kgregg384/SUNLU_AMS_Heater_AutoVent/README.md

# SUNLU AMS Heater Auto-Vent Controller

An intelligent, automatic vent controller for SUNLU AMS 3D printer filament dryers. It monitors AC current draw to detect heater and fan states, then drives a servo-operated vent to manage moisture removal, temperature, and energy consumption — all without any manual intervention.

## How It Works

The controller uses a hall-effect current sensor (ACS758) to non-invasively monitor your dryer's power consumption. A 16-bit ADC (ADS1115) provides precise current measurements, allowing the system to distinguish between three states:

- **Heater + Fan running** — vent opens immediately
- **Fan only** (after the heater stops) — vent stays open for a 3-minute cooldown, then closes
- **Idle** — vent closes immediately

A self-learning calibration mode lets the controller adapt to your specific dryer model by measuring the actual current signatures.

## Features

- **Automatic operation** — no manual vent management needed
- **Self-learning calibration** — adapts to any compatible dryer
- **Non-volatile storage** — learned thresholds survive power cycles
- **Servo position feedback** — closed-loop vent positioning
- **Dual board support** — works with Seeed XIAO SAMD21 or RP2040
- **Single-button interface** — short/long/very-long press for different functions
- **LED status indication** — see what the controller is doing at a glance
- **Serial debug console** — full diagnostic output and manual control commands
- **Serial Monitor app** — GUI tool with color-coded output, quick command buttons, and remote learning mode
- **Pre-built UF2 firmware** — flash without compiling using drag-and-drop

## Hardware

### Components

| Component | Model | Purpose |
|---|---|---|
| Microcontroller | Seeed XIAO SAMD21 **or** RP2040 | Main controller (identical pinout) |
| Current Sensor | ACS758 LCB-050B | AC current measurement (±50A) |
| ADC | ADS1115 | 16-bit I2C analog-to-digital converter |
| Servo | Feedback-enabled servo | Vent actuation with position feedback |
| Button + LED | Mini illuminated pushbutton (Adafruit 3104 or 3105) | Button and status LED in one part; series resistors are on the PCB |
| PCB | Custom (from [3dcreator.shop](https://3dcreator.shop)) | Bare board or kit with components |

You'll also need a 5V power source rated over 1A (barrel jack, or a quality 2A USB-C adapter into the XIAO). The full parts list is in the [Build Guide](BUILD_GUIDE.md).

### Pin Configuration

| Pin | Function | Notes |
|-----|---|---|
| D0 | Servo PWM | Output |
| D3 | Button | Input, active low, internal pullup |
| D10 | Status LED | Active low |
| SDA/SCL | I2C | ADS1115 @ address 0x48 |

ADS1115 channels: A0 = current sensor, A1 = servo feedback.

### 3D Printed Parts

STL files for the vent mechanism and mounting hardware are available at MakerWorld. Approximate print time: ~4 hours.
  - V1: https://makerworld.com/en/models/2038244-sunlu-ams-heater-autovent#profileId-2198796
  - V2: https://makerworld.com/en/models/2344707-autovent-2-0-for-sunlu-ams-heater#profileId-2563439

## Getting Started

### Prerequisites

- [Arduino IDE](https://www.arduino.cc/ide) or [PlatformIO](https://platformio.org/)
- Board package for your XIAO variant:
  - **SAMD21**: Seeed SAMD Boards
  - **RP2040**: Seeed RP2040 Boards (via [Earle Philhower's core](https://github.com/earlephilhower/arduino-pico))
- Required libraries:
  - `Adafruit ADS1X15`
  - `Servo`
  - `Wire`
  - `FlashStorage` (SAMD21) or `EEPROM` (RP2040)

### Upload Firmware

**Option A: Pre-built UF2 (no Arduino IDE needed)**

1. Enter bootloader mode:
   - **RP2040**: Hold the BOOT button while connecting USB-C. A drive named `RPI-RP2` will appear.
   - **SAMD21**: Double-tap the reset pads. A drive named `Arduino` will appear.
2. Drag and drop the appropriate UF2 file onto the drive:

   | File | Board | Design |
   |------|-------|--------|
   | `SUNLU_AMS_Heater_AutoVent_RP2040_v1.uf2` | RP2040 | v1 |
   | `SUNLU_AMS_Heater_AutoVent_RP2040_v2.uf2` | RP2040 | v2 |
   | `SUNLU_AMS_Heater_AutoVent_SAMD21_v1.uf2` | SAMD21 | v1 |
   | `SUNLU_AMS_Heater_AutoVent_SAMD21_v2.uf2` | SAMD21 | v2 |

   The v1 and v2 versions correspond to different 3D printed designs that drive the vent from opposite sides, reversing the servo travel direction. Choose the file that matches your board and printed parts.
3. The board reboots automatically and starts running

**Option B: Compile from source (SAMD21 or RP2040)**

1. Install the [Arduino IDE](https://www.arduino.cc/ide)
2. Add the Seeed board package:
   - Go to **File > Preferences**
   - Add this URL to **Additional Board Manager URLs**:
     - SAMD21: `https://files.seeedstudio.com/arduino/package_seeeduino_boards_index.json`
     - RP2040: `https://github.com/earlephilhower/arduino-pico/releases/download/global/package_rp2040_index.json`
   - Go to **Tools > Board > Board Manager**, search for "Seeed" or "RP2040", and install
3. Install required libraries via **Tools > Manage Libraries**:
   - `Adafruit ADS1X15`
   - `FlashStorage` (SAMD21 only)
4. Connect your XIAO board via USB-C
5. Select the correct board under **Tools > Board**:
   - SAMD21: **Seeeduino XIAO**
   - RP2040: **Seeed XIAO RP2040**
6. Select the correct port under **Tools > Port**
7. Open `SUNLU_AMS_Heater_AutoVent.ino` and click **Upload**

The firmware automatically detects which board it's running on at compile time — no configuration needed.

### First-Time Setup

1. Assemble the PCB and 3D printed parts, mount onto your dryer
2. Connect AC power to the AutoVent and USB-C power to the controller
3. Wait for the LED to go solid. Normal startup calibration takes about 10 seconds; the very first startup also finds the vent's stops and saves the servo travel limits, which adds roughly 20–30 seconds (see [Servo Setup](#servo-setup))
4. Run **Learning Mode** to teach the controller your dryer's current signature:
   - Ensure dryer is OFF
   - Hold the button for 6–7 seconds to enter learning mode
   - Follow the LED prompts through 3 measurement phases (~45 seconds total)
   - Settings are saved automatically

See the [User Guide](USER_GUIDE.md) for detailed step-by-step instructions.

## Button Controls

| Press Duration | Action |
|---|---|
| < 2 seconds | Recalibrate servo |
| 2–5 seconds | Toggle standby mode |
| > 5 seconds | Enter learning mode |

## LED Patterns

| Pattern | Meaning |
|---|---|
| Solid | Normal operation / waiting for input |
| Off | Standby mode |
| Slow flash | Servo calibrating |
| Fast flash | Measuring (learning mode) or servo setup in progress |
| Double blink | Servo not set up — vent won't move until limits are set (send `A`) |
| 3 long blinks | Learning complete |

## Serial Monitor App

A dedicated GUI serial monitor is included in the `SerialMonitor/` folder. It provides color-coded output, quick command buttons, auto-detection of the board, and the ability to run the full learning mode remotely without pressing the physical button.

See the **[Serial Monitor Setup Guide](SerialMonitor/README.md)** for installation and usage instructions.

## Serial Debug

You can also use any serial terminal at 115200 baud. Available commands:

| Command | Action |
|---|---|
| `O` / `o` | Open vent |
| `C` / `c` | Close vent |
| `R` / `r` | Recalibrate servo |
| `F` / `f` | Read servo feedback |
| `S` / `s` | Toggle standby |
| `L` / `l` | Enter learning mode |
| `0`–`180` | Move servo to angle |
| `A` / `a` | Servo setup — find the stops automatically |
| `?` | Show the command menu |
| `J` / `j` | Servo setup — jog by hand to find the stops |

### Servo Setup

On first startup (or any calibration with no saved limits) the controller runs **Auto Find** and saves the result. After that, startup and recalibration only move between the saved limits and never drive the servo into the stops. You can redo or override the limits from the console at any time. If automatic setup fails, the LED double-blinks, the status line shows `SERVO NOT SET UP`, and the vent won't move until you set the limits with `A` or `J`.

**Automatic:** send `A`. The servo moves to mid-travel, measures how the feedback follows it, then creeps toward each end until the feedback stops following (the vent hit a stop). Each limit is pulled in from its stop by about 13% of the measured travel (about 16° on a typical unit). Type either angle and press Enter to check it, then send `W` to save.

**By hand:** send `J`, step with `+`/`-` (1°) or `>`/`<` (5°) until the vent stops moving (a warning prints when the feedback stops following), back off about 10–15°, and send `C` to mark CLOSED. Repeat at the other end with `O`, then send `W`.

`Q` exits without saving, and `D` deletes the saved limits (the next calibration runs Auto Find again). Limits are stored in flash and survive power cycles. Automatic vent control and the button are paused during setup.

## Documentation

- **[Build Guide](BUILD_GUIDE.md)** — Photo-illustrated assembly and installation, step by step
- **[User Guide](USER_GUIDE.md)** — Setup, operation, troubleshooting, and maintenance
- **[Technical Specification](TECHNICAL_SPECIFICATION.md)** — Algorithms, timing, hardware details, and architecture

## Project Structure

```
SUNLU_AMS_Heater_AutoVent.ino             # Main firmware (SAMD21 + RP2040)
SUNLU_AMS_Heater_AutoVent_RP2040_v1.uf2   # Pre-built UF2 — RP2040, v1 design
SUNLU_AMS_Heater_AutoVent_RP2040_v2.uf2   # Pre-built UF2 — RP2040, v2 design
SUNLU_AMS_Heater_AutoVent_SAMD21_v1.uf2   # Pre-built UF2 — SAMD21, v1 design
SUNLU_AMS_Heater_AutoVent_SAMD21_v2.uf2   # Pre-built UF2 — SAMD21, v2 design
SerialMonitor/                             # GUI serial monitor app (Python/tkinter)
  serial_monitor.py                        #   Main application
  requirements.txt                         #   Python dependencies
  install_dependencies.bat                 #   Windows dependency installer
  build_windows_exe.bat                    #   Build standalone .exe
  test_imports.py                          #   Dependency verification script
USER_GUIDE.md                              # End-user documentation
TECHNICAL_SPECIFICATION.md                 # Technical reference
```

## PCBs and Kits

Custom PCBs (bare boards and assembled kits) are available from **[3dcreator.shop](https://3dcreator.shop)**.

## License

MIT

## Contributing

Issues and pull requests are welcome. If you've adapted this for a different dryer model, feel free to share your experience.
