kgregg384/SUNLU_AMS_Heater_AutoVent/SUNLU_AMS_Heater_AutoVent.ino

/*
 * SUNLU AMS Heater Auto-Vent Controller
 *
 * Automated vent control system for 3D printer filament dryers based on current monitoring.
 * Detects heater and fan operation via AC current sensing and automatically controls a
 * servo-operated vent to manage humidity and heat dissipation.
 *
 * Features:
 * - Automatic current-based heater/fan detection
 * - Servo-controlled vent with position feedback
 * - Self-learning threshold calibration mode
 * - EEPROM storage for learned parameters
 * - LED status indication
 * - Button-based user interface
 * - 3-minute fan cooldown delay
 *
 * Hardware:
 * - Board: Seeed XIAO SAMD21 OR Seeed XIAO RP2040 (auto-detected)
 *   - SAMD21: 3.3V, 48MHz ARM Cortex-M0+, 256KB Flash, 32KB SRAM
 *   - RP2040: 3.3V, 133MHz Dual ARM Cortex-M0+, 2MB Flash, 264KB SRAM
 * - Current Sensor: ACS758 LCB-050B (AC current, 40mV/A sensitivity)
 * - ADC: ADS1115 16-bit I2C ADC (±4.096V range)
 * - Servo: Feedback-enabled servo motor
 * - LED: Status indicator (active high, 220Ohm series to GND)
 * - Button: Momentary push button (active low, internal pullup)
 *
 * Pin Configuration (identical physical pins on both boards):
 * - D0: Servo PWM output
 * - D3: Button input (active low, internal pullup)
 * - D10: Status LED (active high, 220Ohm series to GND)
 * - SDA/SCL: I2C bus for ADS1115
 *
 * ADS1115 Channel Mapping:
 * - A0: ACS758 current sensor output
 * - A1: Servo position feedback
 *
 * License: MIT
 * Version: See FIRMWARE_VERSION below
 */

// Firmware Version (Semantic Versioning)
#define FIRMWARE_VERSION "2.1.0"
#define FIRMWARE_DATE __DATE__
#define FIRMWARE_TIME __TIME__

// Hardware Version Selection
// Version 1: Servo open at 10°, closed at 170°
// Version 2: Servo open at 0°, closed at 180° (current default)
#define HARDWARE_VERSION 2

// Board detection and conditional compilation
#if defined(ARDUINO_ARCH_SAMD)
  #define BOARD_SAMD21
  #include <FlashStorage.h>  // SAMD21 EEPROM emulation
  #define MY_BOARD_NAME "SAMD21"
#elif defined(ARDUINO_ARCH_RP2040)
  #define BOARD_RP2040
  #include <EEPROM.h>  // RP2040 EEPROM emulation
  #include <hardware/gpio.h>
  #include <hardware/pwm.h>
  #define MY_BOARD_NAME "RP2040"
#else
  #error "Unsupported board! This code requires Seeed XIAO SAMD21 or RP2040"
#endif

#include <Wire.h>
#include <Adafruit_ADS1X15.h>
#include <Servo.h>
#include <math.h>

#ifdef BOARD_RP2040
  #include <Adafruit_NeoPixel.h>
#endif

// ----------------- Pin Definitions -----------------
// RP2040 requires D prefix, SAMD21 uses numeric pins
// Both boards have identical physical pinout on XIAO form factor
#ifdef BOARD_RP2040
  #define SERVO_PWM_PIN    D0   // Servo PWM output (GPIO26)
  #define LED_PIN          D10  // Status LED (GPIO3)
  #define BUTTON_PIN       D3   // Button input (GPIO29)
  // GPIO numbers for RP2040 hardware control
  #define GPIO_SERVO       26   // D0 = GPIO26
  #define GPIO_LED         3    // D10 = GPIO3
  #define GPIO_BTN         29   // D3 = GPIO29
#else  // SAMD21
  #define SERVO_PWM_PIN    0    // Servo PWM output
  #define LED_PIN          10   // Status LED
  #define BUTTON_PIN       3    // Button input
#endif

// ----------------- Constants -----------------
#define ADS_CH_CURRENT   0   // ACS758 -> ADS A0
#define ADS_CH_SERVO_FB  1   // Servo feedback -> ADS A1

static const float ADS_LSB_V     = 0.000125f;   // ADS1115 @ GAIN_ONE (±4.096V range)
static const float SENS_V_PER_A  = 0.040f;      // ACS758 LCB-050B @ 5V ≈ 40 mV/A
static const uint32_t SAMPLE_MS  = 500;         // Sample for 500ms (~30 AC cycles @ 60Hz)
static const uint32_t OFFSET_MEASURE_MS = 5000; // 5 seconds to measure offset at startup
static const uint32_t ROLLING_AVG_MS = 30000;   // 30 second rolling average window
static const uint8_t MAX_SAMPLES = 60;          // Store 60 samples (30 seconds at 0.5s per sample)

// Detection thresholds - Can be learned or set manually
// These defaults will be used if no learned values are stored in EEPROM
static float HEATER_ON_THRESHOLD  = 0.200f;  // Above this = heater on (200mA)
static float HEATER_OFF_THRESHOLD = 0.120f;  // Below this = heater off (120mA)
static float FAN_ON_THRESHOLD     = 0.025f;  // Above this = fan on (25mA, above baseline ~13mA)
static float FAN_OFF_THRESHOLD    = 0.020f;  // Below this = fan off (20mA, with hysteresis)

// Simple activity detection - anything running vs completely idle
// This is what you'll likely use for actual vent control
static const float ACTIVITY_THRESHOLD    = 0.100f;  // Above this = something is running (100mA)
static const float IDLE_THRESHOLD        = 0.080f;  // Below this = completely idle (80mA)

// ----------------- ACS758 Self-Test Configuration -----------------
// The ACS758 is a ratiometric sensor: with no current flowing, a BIDIRECTIONAL
// variant parks its output at Vcc/2. At the 5V sensor supply that is ~2.500V.
// The ADS1115 runs off 3.3V, so anything it reads clamps near 3.3V regardless
// of the +/-4.096V GAIN_ONE full scale.
//
// NOTE: verify ACS_VQ_NOMINAL against a real board before trusting the PASS
// window - if this sensor is a UNIdirectional variant the quiescent point is
// ~0.12*Vcc (~0.6V) instead, and every reading below will look like a fault.
static const float ACS_VCC_NOMINAL   = 5.000f;                    // ACS758 supply rail
static const float ACS_VQ_NOMINAL    = ACS_VCC_NOMINAL * 0.5f;    // Expected idle output (bidirectional)
static const float ACS_VQ_TOL        = 0.350f;  // +/- window around Vq counted as healthy
static const float ACS_V_DEAD_LOW    = 0.200f;  // Below this = dead short / no signal
static const float ACS_V_RAIL_HIGH   = 3.200f;  // Above this = pinned at the ADS 3.3V rail
static const float ACS_V_IMPOSSIBLE   = 1.000f;  // |mean-Vq| beyond this cannot be a healthy sensor
static const float ACS_NOISE_MAX_V   = 0.050f;  // Idle pk-pk above this = noisy or live load
static const float ACS_FLOAT_DRAG_V  = 0.030f;  // Mux settling drag that implies a high-Z pin
static const float ACS_FLOAT_MIN_SEP = 0.500f;  // Min A1-vs-A0 separation for the drag test
static const uint8_t ACS_TEST_SAMPLES = 64;     // Samples used for the DC/noise measurement

// Self-test verdicts, worst-first
enum AcsTestResult {
  ACS_PASS = 0,
  ACS_WARN_NOISY,
  ACS_WARN_OFF_NOMINAL,
  ACS_FAIL_FLOATING,
  ACS_FAIL_BIAS,
  ACS_FAIL_LOW,
  ACS_FAIL_HIGH
};

AcsTestResult g_acsTestResult = ACS_PASS;

// Default closed/open angles for each hardware version (full servo sweep).
// Only used for manual moves until the servo travel limits are set up.
#if HARDWARE_VERSION == 1
  static const int DEFAULT_CLOSED_DEG = 170;
  static const int DEFAULT_OPEN_DEG   = 10;
#else
  // Physical servo is reversed, so closed is the max angle
  static const int DEFAULT_CLOSED_DEG = 180;
  static const int DEFAULT_OPEN_DEG   = 0;
#endif

// Servo positions in DEGREES (hardware version dependent)
#if HARDWARE_VERSION == 1
  static int SERVO_CLOSED_DEG = 170;  // Version 1: Closed position
  static int SERVO_OPEN_DEG   = 10;   // Version 1: Open position
#else
  static int SERVO_CLOSED_DEG = 20;   // Version 2: Initial (updated during calibration)
  static int SERVO_OPEN_DEG   = 160;  // Version 2: Initial (updated during calibration)
#endif

// Feedback calibration values (Adafruit method)
// These map feedback readings to servo positions
static float g_minFeedback = 0.0f;   // Feedback at closed position
static float g_maxFeedback = 1.0f;   // Feedback at open position

// Last angle written to the servo (jog mode starts from here)
static int g_servoDeg = SERVO_CLOSED_DEG;

// User-set travel limits from jog mode (used instead of the hardware defaults when saved)
bool g_servoLimitsSaved = false;
int g_savedClosedDeg = 0;
int g_savedOpenDeg = 0;

// Auto stop-finding settings
// Each limit is set this fraction of the stop-to-stop travel short of its stop.
// 12.7% matches a hand-tuned unit: closed stop found at ~126 deg, open end at 0 deg,
// closed limit set by hand at 110 deg -> 16 / 126.
static const float SERVO_STOP_BACKOFF_PCT = 12.7f;
static const float STOP_LAG_DEG = 5.0f;        // Shaft this far behind the command = blocked by a stop

// Feedback change per commanded degree, measured over free travel (0 = unknown)
float g_fbPerDeg = 0.0f;

// Jog mode state
bool g_jogMode = false;
int g_jogClosedDeg = -1;   // Marked but not yet saved (-1 = not marked)
int g_jogOpenDeg = -1;
float g_jogLastFb = 0.0f;
int g_jogLastDir = 0;
uint8_t g_jogNoMoveCount = 0;

// ----------------- Globals -----------------
Adafruit_ADS1115 ads;
Servo servo;

// Offset tracking
float g_voltageOffset = 0.0f;

// Rolling average circular buffer
float g_currentSamples[MAX_SAMPLES];
uint8_t g_sampleIndex = 0;
uint8_t g_sampleCount = 0;
uint32_t g_lastUpdateMs = 0;
uint32_t g_lastDebugOutputMs = 0;  // Timer for debug output throttling

// Vent control state
bool g_ventOpen = false;
bool g_heaterWasOn = false;
uint32_t g_ventCloseDelayStart = 0;
bool g_ventClosePending = false;
static const uint32_t VENT_CLOSE_DELAY_MS = 180000;  // 3 minute delay before closing

// Device state detection (global so they can be reset during calibration)
bool g_fanOn = false;
bool g_heaterOn = false;
bool g_systemActive = false;

// Serial input buffer for numeric commands
char g_serialBuffer[8];
uint8_t g_serialIdx = 0;

// Calibration and LED state
bool g_calibrated = false;
uint32_t g_lastLedToggle = 0;
bool g_ledState = false;
static const uint32_t LED_FLASH_INTERVAL = 250;  // Flash every 250ms during calibration

// Built-in LED breathing effect (RP2040 only)
#ifdef BOARD_RP2040
  uint32_t g_breathingStartMs = 0;
  static const uint32_t BREATHING_PERIOD_MS = 3000;  // 3 second breathing cycle
  static const uint8_t BREATHING_MIN = 2;   // Minimum brightness (never fully off)
  static const uint8_t BREATHING_MAX = 40;  // Maximum brightness (dimmer)
  static const uint8_t NEOPIXEL_POWER_PIN = 11;  // NeoPixel power pin (must be HIGH)
  static const uint8_t NEOPIXEL_DATA_PIN = 12;   // NeoPixel data pin (GPIO12 on XIAO RP2040)
  static const uint8_t NEOPIXEL_COUNT = 1;       // One NeoPixel LED
  Adafruit_NeoPixel neopixel(NEOPIXEL_COUNT, NEOPIXEL_DATA_PIN, NEO_GRB + NEO_KHZ800);
#endif

// Button state for edge detection and long press
bool g_lastButtonState = HIGH;
uint32_t g_buttonPressStart = 0;
bool g_buttonHandled = false;
bool g_ignoreNextRelease = false;  // Flag to ignore button release after entering learning mode
static const uint32_t LONG_PRESS_MS = 2000;   // 2 second long press
static const uint32_t VLONG_PRESS_MS = 5000;  // 5 second very long press for learning mode

// System power state (standby mode)
bool g_systemOn = true;

// Learning mode state
enum LearningPhase {
  LEARN_NONE = 0,
  LEARN_BASELINE,
  LEARN_HEATER,
  LEARN_FAN_ONLY,
  LEARN_COMPLETE
};
LearningPhase g_learningPhase = LEARN_NONE;
float g_learnedBaseline = 0.0f;
float g_learnedHeater = 0.0f;
float g_learnedFanOnly = 0.0f;
uint32_t g_learningStartMs = 0;  // When measurement started (0 = in prep phase)
uint32_t g_learningPhaseEntryMs = 0;  // When phase was entered
static const uint32_t LEARNING_MEASURE_MS = 10000;  // 10 seconds per phase
static const uint32_t LEARNING_PREP_MS = 5000;  // 5 seconds prep time before auto-start

// LED patterns
enum LEDPattern {
  LED_SOLID,
  LED_FAST_FLASH,      // 100ms - learning mode active
  LED_SLOW_FLASH,      // 250ms - calibration
  LED_DOUBLE_BLINK,    // Double blink pattern
  LED_BREATHING,       // Slow breathing pattern
  LED_SUCCESS_BLINK,   // 2 quick flashes
  LED_COMPLETE_BLINK,  // 3 long flashes
  LED_OFF
};
LEDPattern g_ledPattern = LED_SOLID;
uint32_t g_ledPatternStart = 0;

// EEPROM structure for storing learned thresholds
struct ThresholdData {
  uint32_t magic;  // Magic number to verify valid data
  float fanOnThreshold;
  float fanOffThreshold;
  float heaterOnThreshold;
  float heaterOffThreshold;
};
static const uint32_t EEPROM_MAGIC = 0xABCD1234;

// Servo travel limits, stored separately so saving them never touches the thresholds.
// HARDWARE_VERSION is part of the magic so limits saved for v1 are ignored by v2 firmware.
struct ServoLimitsData {
  uint32_t magic;
  int16_t closedDeg;
  int16_t openDeg;
};
static const uint32_t SERVO_LIMITS_MAGIC = 0x5E770000UL | HARDWARE_VERSION;
static const int SERVO_LIMITS_EEPROM_ADDR = 64;  // RP2040: after ThresholdData at 0

#ifdef BOARD_SAMD21
  FlashStorage(thresholdStorage, ThresholdData);
  FlashStorage(servoLimitsStorage, ServoLimitsData);
#endif

// ----------------- Helper Functions -----------------

#ifdef BOARD_RP2040
// Update built-in NeoPixel with smooth breathing effect (RP2040 only)
// Uses NeoPixel library for WS2812B RGB LED control
// Color changes based on heater state: RED = heater on, BLUE = heater off
void updateBuiltinLEDBreathing() {
  uint32_t now = millis();
  uint32_t elapsed = now - g_breathingStartMs;
  uint32_t phase = elapsed % BREATHING_PERIOD_MS;

  // Calculate brightness using sine wave approximation
  // Phase goes from 0 to BREATHING_PERIOD_MS
  float t = (float)phase / (float)BREATHING_PERIOD_MS;  // 0.0 to 1.0

  // Use sine wave: sin(2*PI*t) ranges from -1 to 1
  // Convert to 0 to 1: (sin(2*PI*t) + 1) / 2
  float angle = t * 2.0f * 3.14159f;
  float brightness = (sin(angle) + 1.0f) / 2.0f;

  // Map to brightness range with minimum brightness
  uint8_t brightnessValue = BREATHING_MIN + (uint8_t)(brightness * (BREATHING_MAX - BREATHING_MIN));

  // Seeed XIAO RP2040: NeoPixel on pin 12 (data), pin 11 (power)
  // Color based on heater state: RED = heater on, BLUE = heater off
  if (g_heaterOn) {
    // Red when heater is on
    neopixel.setPixelColor(0, neopixel.Color(brightnessValue, 0, 0));
  } else {
    // Blue when heater is off
    neopixel.setPixelColor(0, neopixel.Color(0, 0, brightnessValue));
  }
  neopixel.show();
}
#endif

// LED pattern handler - call this frequently from loop()
void updateLEDPattern() {
  uint32_t now = millis();
  uint32_t elapsed = now - g_ledPatternStart;

  switch (g_ledPattern) {
    case LED_SOLID:
      digitalWrite(LED_PIN, HIGH);
      #ifdef BOARD_SAMD21
        digitalWrite(LED_BUILTIN, HIGH);
      #endif
      break;

    case LED_FAST_FLASH:  // 100ms on/off for learning mode
      if (now - g_lastLedToggle >= 100) {
        g_ledState = !g_ledState;
        digitalWrite(LED_PIN, g_ledState);
        #ifdef BOARD_SAMD21
          digitalWrite(LED_BUILTIN, g_ledState);
        #endif
        g_lastLedToggle = now;
      }
      break;

    case LED_SLOW_FLASH:  // 250ms on/off for calibration
      if (now - g_lastLedToggle >= 250) {
        g_ledState = !g_ledState;
        digitalWrite(LED_PIN, g_ledState);
        #ifdef BOARD_SAMD21
          digitalWrite(LED_BUILTIN, g_ledState);
        #endif
        g_lastLedToggle = now;
      }
      break;

    case LED_DOUBLE_BLINK:  // Double blink every 2 seconds
      if (elapsed < 150) {
        digitalWrite(LED_PIN, HIGH);
        #ifdef BOARD_SAMD21
          digitalWrite(LED_BUILTIN, HIGH);
        #endif
      } else if (elapsed < 300) {
        digitalWrite(LED_PIN, LOW);
        #ifdef BOARD_SAMD21
          digitalWrite(LED_BUILTIN, LOW);
        #endif
      } else if (elapsed < 450) {
        digitalWrite(LED_PIN, HIGH);
        #ifdef BOARD_SAMD21
          digitalWrite(LED_BUILTIN, HIGH);
        #endif
      } else if (elapsed < 2000) {
        digitalWrite(LED_PIN, LOW);
        #ifdef BOARD_SAMD21
          digitalWrite(LED_BUILTIN, LOW);
        #endif
      } else {
        g_ledPatternStart = now;
      }
      break;

    case LED_BREATHING:  // Slow breathing pattern using PWM
      {
        // Simple approximation using on/off timing
        uint32_t cycle = elapsed % 2000;
        if (cycle < 1000) {
          // Fade in - use simple threshold
          digitalWrite(LED_PIN, cycle > 500 ? HIGH : (cycle % 100 < 50 ? HIGH : LOW));
          #ifdef BOARD_SAMD21
            digitalWrite(LED_BUILTIN, cycle > 500 ? HIGH : (cycle % 100 < 50 ? HIGH : LOW));
          #endif
        } else {
          // Fade out
          uint32_t fadeOut = cycle - 1000;
          digitalWrite(LED_PIN, fadeOut < 500 ? HIGH : (fadeOut % 100 < 50 ? HIGH : LOW));
          #ifdef BOARD_SAMD21
            digitalWrite(LED_BUILTIN, fadeOut < 500 ? HIGH : (fadeOut % 100 < 50 ? HIGH : LOW));
          #endif
        }
      }
      break;

    case LED_SUCCESS_BLINK:  // 2 quick flashes then return to solid
      if (elapsed < 150) {
        digitalWrite(LED_PIN, HIGH);
        #ifdef BOARD_SAMD21
          digitalWrite(LED_BUILTIN, HIGH);
        #endif
      } else if (elapsed < 300) {
        digitalWrite(LED_PIN, LOW);
        #ifdef BOARD_SAMD21
          digitalWrite(LED_BUILTIN, LOW);
        #endif
      } else if (elapsed < 450) {
        digitalWrite(LED_PIN, HIGH);
        #ifdef BOARD_SAMD21
          digitalWrite(LED_BUILTIN, HIGH);
        #endif
      } else if (elapsed < 600) {
        digitalWrite(LED_PIN, LOW);
        #ifdef BOARD_SAMD21
          digitalWrite(LED_BUILTIN, LOW);
        #endif
      } else {
        g_ledPattern = LED_SOLID;
      }
      break;

    case LED_COMPLETE_BLINK:  // 3 long flashes then return to solid
      if (elapsed < 500) {
        digitalWrite(LED_PIN, HIGH);
        #ifdef BOARD_SAMD21
          digitalWrite(LED_BUILTIN, HIGH);
        #endif
      } else if (elapsed < 1000) {
        digitalWrite(LED_PIN, LOW);
        #ifdef BOARD_SAMD21
          digitalWrite(LED_BUILTIN, LOW);
        #endif
      } else if (elapsed < 1500) {
        digitalWrite(LED_PIN, HIGH);
        #ifdef BOARD_SAMD21
          digitalWrite(LED_BUILTIN, HIGH);
        #endif
      } else if (elapsed < 2000) {
        digitalWrite(LED_PIN, LOW);
        #ifdef BOARD_SAMD21
          digitalWrite(LED_BUILTIN, LOW);
        #endif
      } else if (elapsed < 2500) {
        digitalWrite(LED_PIN, HIGH);
        #ifdef BOARD_SAMD21
          digitalWrite(LED_BUILTIN, HIGH);
        #endif
      } else if (elapsed < 3000) {
        digitalWrite(LED_PIN, LOW);
        #ifdef BOARD_SAMD21
          digitalWrite(LED_BUILTIN, LOW);
        #endif
      } else {
        g_ledPattern = LED_SOLID;
      }
      break;

    case LED_OFF:
      digitalWrite(LED_PIN, LOW);
      #ifdef BOARD_SAMD21
        digitalWrite(LED_BUILTIN, LOW);
      #endif
      break;
  }
}

// Set LED pattern
void setLEDPattern(LEDPattern pattern) {
  g_ledPattern = pattern;
  g_ledPatternStart = millis();
  g_lastLedToggle = millis();
}

// Delay while flashing LED (for calibration)
void delayWithFlashing(uint32_t ms) {
  uint32_t start = millis();
  while (millis() - start < ms) {
    if (millis() - g_lastLedToggle >= LED_FLASH_INTERVAL) {
      g_ledState = !g_ledState;
      digitalWrite(LED_PIN, g_ledState);
      g_lastLedToggle = millis();
    }
  }
}

inline float readVolts(uint8_t ch) {
  int16_t raw = ads.readADC_SingleEnded(ch);
  return raw * ADS_LSB_V;
}

// Median filter for servo feedback (reduce noise)
static inline float median3(float a, float b, float c) {
  float x = a, y = b, z = c;
  if (x > y) { float t = x; x = y; y = t; }
  if (y > z) { float t = y; y = z; z = t; }
  if (x > y) { float t = x; x = y; y = t; }
  return y;
}

// Read servo feedback position (0.0 to 1.0)
float readServoFeedback01() {
  float v1 = readVolts(ADS_CH_SERVO_FB);
  float v2 = readVolts(ADS_CH_SERVO_FB);
  float v3 = readVolts(ADS_CH_SERVO_FB);
  float v  = median3(v1, v2, v3);
  float x  = v / 3.3f;
  if (x < 0) x = 0; if (x > 1) x = 1;
  return x;
}

// Convert feedback reading to degrees (using calibration)
int feedbackToDeg(float fb) {
  // Linear interpolation: map feedback range to degree range
  float t = (fb - g_minFeedback) / (g_maxFeedback - g_minFeedback);
  if (t < 0) t = 0;
  if (t > 1) t = 1;
  return SERVO_CLOSED_DEG + (int)(t * (SERVO_OPEN_DEG - SERVO_CLOSED_DEG));
}

// Convert degrees to expected feedback (using calibration)
float degToFeedback(int deg) {
  float t = (float)(deg - SERVO_CLOSED_DEG) / (float)(SERVO_OPEN_DEG - SERVO_CLOSED_DEG);
  if (t < 0) t = 0;
  if (t > 1) t = 1;
  return g_minFeedback + t * (g_maxFeedback - g_minFeedback);
}

// Measure RMS current over a time period using Welford's online algorithm
float measureIrmsOver(uint32_t ms) {
  uint32_t t0 = millis();
  double mean = 0.0, M2 = 0.0;
  uint32_t n = 0;

  while ((millis() - t0) < ms) {
    float v = readVolts(ADS_CH_CURRENT) - g_voltageOffset;  // Apply offset correction
    n++;
    double d  = v - mean;
    mean     += d / n;
    double d2 = v - mean;
    M2       += d * d2;
  }

  if (n < 2) return 0.0f;

  double var = M2 / (n - 1);
  double vrms_ac = sqrt(fmax(0.0, var));

  return (float)(vrms_ac / SENS_V_PER_A);
}

// Calculate voltage offset by averaging readings over a period
float calculateOffset(uint32_t ms) {
  uint32_t t0 = millis();
  double sum = 0.0;
  uint32_t n = 0;

  Serial.println(F("Measuring voltage offset (ensure no load on ACS758)..."));

  while ((millis() - t0) < ms) {
    float v = readVolts(ADS_CH_CURRENT);
    sum += v;
    n++;

    // Flash LED during offset measurement
    if (millis() - g_lastLedToggle >= LED_FLASH_INTERVAL) {
      g_ledState = !g_ledState;
      digitalWrite(LED_PIN, g_ledState);
      g_lastLedToggle = millis();
    }

    // Print progress every 500ms
    if (n % 50 == 0) {
      Serial.print(F("."));
    }
  }

  Serial.println();

  if (n == 0) return 0.0f;

  float offset = (float)(sum / n);
  Serial.print(F("Offset calculated: "));
  Serial.print(offset, 6);
  Serial.print(F("V from "));
  Serial.print(n);
  Serial.println(F(" samples"));

  return offset;
}

// ----------------- ACS758 / PCB Connectivity Self-Test -----------------
//
// Checks that the current sensor is actually wired to ADS1115 A0 and alive,
// without needing any load current. Three independent checks:
//
//   1. DC bias    - an idle bidirectional ACS758 sits at Vcc/2 (~2.5V). Near 0V
//                   means no signal (unpowered sensor, open VOUT trace, or VOUT
//                   shorted to GND). Near the 3.3V rail means VOUT is shorted
//                   high or the ADS input is clamping.
//   2. Mux drag   - the ADS1115 multiplexes one sampling capacitor across all
//                   four inputs. Charge it up on A1 (servo feedback), then read
//                   A0 immediately: a low-impedance driven pin pulls the cap to
//                   its own voltage in the first conversion, while a FLOATING
//                   pin lets the residual A1 charge dominate and then drifts
//                   over the next few reads. A large first-read-vs-settled
//                   delta means A0 is not actually connected to anything.
//   3. Noise floor- a healthy idle sensor is quiet (a few mV pk-pk). A large
//                   spread means either real load current (dryer powered on) or
//                   a floating/noise-coupled input.
//
// CAUTION: check 2 is a heuristic, not a datasheet-guaranteed behavior, AND on
// the current PCB it is expected to be DEAD CODE: C4 (.1uF) sits on the A0 net
// at the ADS side of R5, so A0 is never high-impedance from the ADC's point of
// view and the sampling cap always finds charge locally. Check 1 is what
// actually catches a disconnected sensor here - with the sensor unplugged, C4
// has nothing to charge it and A0 sits near 0V, tripping ACS_FAIL_LOW.
// Check 2 is retained only for a future board that drops C4. Validate it on the
// bench before trusting it; ACS_FLOAT_DRAG_V is the knob to tune.
//
// PCB CONTEXT (from AutoVent_KiCad/SAMD21 Schematic.kicad_sch):
//   J4 "ACS_Conn" = UNKEYED 1x03 2.54mm header - pin1 +5V, pin2 GND, pin3 VOUT
//   VOUT -> R5 (1k series) -> A0 -> C4 (.1uF to GND) -> J3 ADS1115 breakout
//   R5 limits back-drive into the ADC to ~1.4mA if J4 is reversed.
//
AcsTestResult runAcsSelfTest(bool verbose) {
  if (verbose) {
    Serial.println(F("\n--- ACS758 CONNECTIVITY SELF-TEST ---"));
  }

  // --- Check 1 + 3: DC bias and noise floor on A0 ---
  double sum = 0.0;
  float vMin = 1e6f, vMax = -1e6f;
  for (uint8_t i = 0; i < ACS_TEST_SAMPLES; i++) {
    float v = readVolts(ADS_CH_CURRENT);
    sum += v;
    if (v < vMin) vMin = v;
    if (v > vMax) vMax = v;
  }
  float vMean = (float)(sum / ACS_TEST_SAMPLES);
  float vPkPk = vMax - vMin;

  // --- Check 2: mux settling drag (floating-input detector) ---
  // Park the ADS sampling cap on A1, then watch how A0 behaves on the very
  // first conversion versus after it has had several conversions to settle.
  float vRef = 0.0f;
  for (uint8_t i = 0; i < 4; i++) vRef = readVolts(ADS_CH_SERVO_FB);
  float vFirst = readVolts(ADS_CH_CURRENT);
  float vSettled = 0.0f;
  for (uint8_t i = 0; i < 8; i++) vSettled = readVolts(ADS_CH_CURRENT);
  float drag = vFirst - vSettled;

  // The test only means anything if A1 sits far enough away from A0 to pull it.
  bool dragValid = (fabsf(vRef - vSettled) >= ACS_FLOAT_MIN_SEP);
  // A floating pin gets dragged TOWARD A1, so require the sign to agree.
  bool draggedTowardRef = ((vRef > vSettled) && (drag > 0.0f)) ||
                          ((vRef < vSettled) && (drag < 0.0f));
  bool floating = dragValid && draggedTowardRef && (fabsf(drag) >= ACS_FLOAT_DRAG_V);

  // --- Verdict, worst fault wins ---
  AcsTestResult result;
  if (vMean < ACS_V_DEAD_LOW) {
    result = ACS_FAIL_LOW;
  } else if (vMean > ACS_V_RAIL_HIGH) {
    result = ACS_FAIL_HIGH;
  } else if (floating) {
    result = ACS_FAIL_FLOATING;
  } else if (fabsf(vMean - ACS_VQ_NOMINAL) > ACS_V_IMPOSSIBLE) {
    // The dryer is an AC load, so its current averages to zero over many cycles
    // and does NOT move the DC mean. A mean this far from Vq is a wiring fault,
    // not a measurement - it is safe to call this a hard failure.
    result = ACS_FAIL_BIAS;
  } else if (fabsf(vMean - ACS_VQ_NOMINAL) > ACS_VQ_TOL) {
    result = ACS_WARN_OFF_NOMINAL;
  } else if (vPkPk > ACS_NOISE_MAX_V) {
    result = ACS_WARN_NOISY;
  } else {
    result = ACS_PASS;
  }

  if (verbose) {
    Serial.print(F("  A0 idle bias : "));
    Serial.print(vMean, 4);
    Serial.print(F("V (expect "));
    Serial.print(ACS_VQ_NOMINAL, 3);
    Serial.print(F("V +/- "));
    Serial.print(ACS_VQ_TOL, 2);
    Serial.println(F("V)"));

    Serial.print(F("  Implied Vcc  : "));
    Serial.print(vMean * 2.0f, 3);
    Serial.println(F("V   <- sanity-check the 5V sensor rail"));

    Serial.print(F("  Noise pk-pk  : "));
    Serial.print(vPkPk * 1000.0f, 1);
    Serial.print(F("mV  (min "));
    Serial.print(vMin, 4);
    Serial.print(F("V / max "));
    Serial.print(vMax, 4);
    Serial.println(F("V)"));

    Serial.print(F("  Mux drag     : "));
    if (!dragValid) {
      Serial.print(F("inconclusive (A1 at "));
      Serial.print(vRef, 3);
      Serial.println(F("V is too close to A0)"));
    } else {
      Serial.print(drag * 1000.0f, 1);
      Serial.print(F("mV toward A1@"));
      Serial.print(vRef, 3);
      Serial.print(F("V  (trip at "));
      Serial.print(ACS_FLOAT_DRAG_V * 1000.0f, 0);
      Serial.println(F("mV)"));
    }

    Serial.print(F("  RESULT       : "));
    switch (result) {
      case ACS_PASS:
        Serial.println(F("PASS - sensor connected and idle"));
        break;
      case ACS_WARN_NOISY:
        Serial.println(F("WARN - reading is noisy"));
        Serial.println(F("    Expected if the dryer is powered ON right now."));
        Serial.println(F("    If the dryer is OFF, suspect a long/unshielded VOUT"));
        Serial.println(F("    run, a missing filter cap, or ground-loop coupling."));
        break;
      case ACS_WARN_OFF_NOMINAL:
        Serial.println(F("WARN - bias present but off-nominal"));
        Serial.println(F("    Sensor is connected, but not parked where expected."));
        Serial.println(F("    Check: 5V rail sagging, a divider on VOUT, DC current"));
        Serial.println(F("    through the sense conductor, or a UNIdirectional part."));
        break;
      case ACS_FAIL_FLOATING:
        Serial.println(F("FAIL - A0 looks DISCONNECTED (high impedance)"));
        Serial.println(F("    A0 tracks the neighboring channel instead of holding"));
        Serial.println(F("    its own voltage. Check the VOUT trace/connector"));
        Serial.println(F("    between the ACS758 and the ADS1115 A0 pin."));
        break;
      case ACS_FAIL_LOW:
        Serial.println(F("FAIL - A0 is at/near 0V"));
        Serial.println(F("    No signal reaching the ADC. Check: ACS758 5V supply,"));
        Serial.println(F("    sensor GND, VOUT shorted to GND, or a solder bridge."));
        break;
      case ACS_FAIL_BIAS:
        Serial.println(F("FAIL - bias present but impossible for a healthy sensor"));
        Serial.println(F("    An AC load cannot shift the DC mean, so this is a"));
        Serial.println(F("    wiring fault. SUSPECT #1: J4 plugged in BACKWARDS."));
        Serial.println(F("    J4 is an unkeyed 3-pin header: 1=+5V 2=GND 3=VOUT."));
        break;
      case ACS_FAIL_HIGH:
        Serial.println(F("FAIL - A0 is pinned at the 3.3V rail"));
        Serial.println(F("    SUSPECT #1: J4 plugged in BACKWARDS. Reversing an"));
        Serial.println(F("    unkeyed 3-pin header swaps +5V (pin1) with VOUT"));
        Serial.println(F("    (pin3), leaving GND on pin2. That un-powers the"));
        Serial.println(F("    ACS758 and drives +5V into its output pin, which"));
        Serial.println(F("    back-feeds A0 through the dead chip. UNPLUG NOW -"));
        Serial.println(F("    R5 protects the ADC, but nothing protects the"));
        Serial.println(F("    sensor from +5V on its VOUT pin."));
        Serial.println(F("    Otherwise: VOUT shorted to a rail, or overcurrent."));
        break;
    }
    Serial.println(F("-------------------------------------\n"));
  }

  return result;
}

// Add sample to rolling average buffer
void addSampleToRollingAvg(float current) {
  g_currentSamples[g_sampleIndex] = current;
  g_sampleIndex = (g_sampleIndex + 1) % MAX_SAMPLES;
  if (g_sampleCount < MAX_SAMPLES) {
    g_sampleCount++;
  }
}

// Calculate rolling average from buffer
float getRollingAverage() {
  if (g_sampleCount == 0) return 0.0f;

  double sum = 0.0;
  for (uint8_t i = 0; i < g_sampleCount; i++) {
    sum += g_currentSamples[i];
  }

  return (float)(sum / g_sampleCount);
}

// Move servo to position (degrees) and detach
void moveServo(int degrees) {
  if (!servo.attached()) {
    servo.attach(SERVO_PWM_PIN);
    delay(50);
  }

  servo.write(degrees);
  g_servoDeg = degrees;
  Serial.print(F("Servo moved to "));
  Serial.print(degrees);
  Serial.println(F(" degrees"));

  delay(500);  // Allow servo to reach position
  servo.detach();
  Serial.println(F("Servo detached"));
}

// Close vent
void closeVent() {
  if (!g_servoLimitsSaved) {
    printServoSetupNotice();
    return;
  }
  Serial.println(F("CLOSING VENT"));
  moveServo(SERVO_CLOSED_DEG);
}

// Open vent
void openVent() {
  if (!g_servoLimitsSaved) {
    printServoSetupNotice();
    return;
  }
  Serial.println(F("OPENING VENT"));
  moveServo(SERVO_OPEN_DEG);
}

// Set SERVO_CLOSED_DEG / SERVO_OPEN_DEG from the jog-mode limits if saved,
// otherwise from the hardware-version defaults (full sweep)
void applyServoLimits() {
  if (g_servoLimitsSaved) {
    SERVO_CLOSED_DEG = g_savedClosedDeg;
    SERVO_OPEN_DEG = g_savedOpenDeg;
    Serial.println(F("  Using saved travel limits"));
  } else {
    SERVO_CLOSED_DEG = DEFAULT_CLOSED_DEG;
    SERVO_OPEN_DEG = DEFAULT_OPEN_DEG;
    Serial.print(F("  Hardware Version "));
    Serial.print(HARDWARE_VERSION);
    Serial.println(F(" default limits"));
  }
  Serial.print(F("  CLOSED position: "));
  Serial.print(SERVO_CLOSED_DEG);
  Serial.println(F(" deg"));
  Serial.print(F("  OPEN position: "));
  Serial.print(SERVO_OPEN_DEG);
  Serial.println(F(" deg"));
}

void printServoSetupNotice() {
  Serial.println(F("\n*** SERVO NOT SET UP - vent will not move automatically ***"));
  Serial.println(F("*** Send 'A' to find the stops automatically, or 'J' to jog  ***\n"));
}

static void calDelay(uint32_t ms, bool flashLed) {
  if (flashLed) delayWithFlashing(ms);
  else delay(ms);
}

// Record feedback at the saved CLOSED and OPEN limits, then return to closed.
// Only moves between the saved limits, so the servo never drives into a stop.
bool calibrateServoFeedback(bool flashLed) {
  if (!g_servoLimitsSaved) {
    printServoSetupNotice();
    return false;
  }

  applyServoLimits();
  if (!servo.attached()) {
    servo.attach(SERVO_PWM_PIN);
  }

  servo.write(SERVO_CLOSED_DEG);
  calDelay(1000, flashLed);
  g_minFeedback = readServoFeedback01();
  Serial.print(F("  CLOSED ("));
  Serial.print(SERVO_CLOSED_DEG);
  Serial.print(F("deg): feedback "));
  Serial.println(g_minFeedback, 4);

  servo.write(SERVO_OPEN_DEG);
  calDelay(1000, flashLed);
  g_maxFeedback = readServoFeedback01();
  Serial.print(F("  OPEN ("));
  Serial.print(SERVO_OPEN_DEG);
  Serial.print(F("deg): feedback "));
  Serial.println(g_maxFeedback, 4);

  if (fabsf(g_maxFeedback - g_minFeedback) < 0.01f) {
    Serial.println(F("WARNING: Feedback barely changed between limits - check servo wiring"));
  }

  servo.write(SERVO_CLOSED_DEG);
  g_servoDeg = SERVO_CLOSED_DEG;
  calDelay(500, flashLed);
  servo.detach();
  return true;
}

// Recalibrate servo feedback ('R' command and after jog mode)
void calibrateFromCurrentPosition() {
  Serial.println(F("\n========================================"));
  Serial.println(F("SERVO RECALIBRATION"));
  Serial.println(F("========================================"));
  calibrateServoFeedback(false);
  Serial.println(F("========================================\n"));
}

// Run full calibration (servo + current offset)
// Called at startup and when button is pressed
void runFullCalibration() {
  g_calibrated = false;  // Mark as not calibrated
  setLEDPattern(LED_SLOW_FLASH);  // Flash LED during calibration

  Serial.println(F("\n========================================"));
  Serial.println(F("FULL CALIBRATION STARTING"));
  Serial.println(F("========================================"));

  // === SERVO CALIBRATION ===
  Serial.println(F("\n--- SERVO CALIBRATION ---"));
  if (!g_servoLimitsSaved) {
    autoSetupServo();
  }
  calibrateServoFeedback(true);

  // === CURRENT OFFSET CALIBRATION ===
  Serial.println(F("\n--- CURRENT OFFSET CALIBRATION ---"));
  Serial.println(F("IMPORTANT: Ensure dryer is OFF"));
  delayWithFlashing(1000);

  g_voltageOffset = calculateOffset(OFFSET_MEASURE_MS);

  // Clear rolling average buffer to remove any stale data
  g_sampleIndex = 0;
  g_sampleCount = 0;
  for (uint8_t i = 0; i < MAX_SAMPLES; i++) {
    g_currentSamples[i] = 0.0f;
  }

  // Mark calibration complete - LED stays solid, vent is closed
  g_calibrated = true;
  g_ventOpen = false;
  g_ventClosePending = false;
  g_heaterWasOn = false;  // Reset heater state tracking
  g_systemOn = true;

  // Reset all device state detection flags (assume everything OFF after calibration)
  g_fanOn = false;
  g_heaterOn = false;
  g_systemActive = false;

  // Solid when ready; double blink means the servo still needs setting up
  setLEDPattern(g_servoLimitsSaved ? LED_SOLID : LED_DOUBLE_BLINK);

  // Allow sensor to settle after calibration
  Serial.println(F("\nAllowing sensor to settle (3 seconds)..."));
  delay(3000);

  Serial.println(F("\n========================================"));
  Serial.println(F("CALIBRATION COMPLETE - System Ready"));
  Serial.println(F("========================================\n"));
}

// Enter standby mode - close vent, turn off LED, stop monitoring
void enterStandbyMode() {
  Serial.println(F("\n========================================"));
  Serial.println(F("ENTERING STANDBY MODE"));
  Serial.println(F("========================================"));

  // Close the vent (only if set up - an unset servo is never driven)
  if (g_servoLimitsSaved) {
    closeVent();
  }
  g_ventOpen = false;
  g_ventClosePending = false;

  // Turn off LED
  setLEDPattern(LED_OFF);

  // Set system off
  g_systemOn = false;

  Serial.println(F("System is now in STANDBY"));
  Serial.println(F("Long press button to wake up"));
  Serial.println(F("========================================\n"));
}

// Load thresholds from EEPROM
bool loadThresholdsFromEEPROM() {
  ThresholdData data;

  #ifdef BOARD_SAMD21
    data = thresholdStorage.read();
  #else  // RP2040
    EEPROM.begin(512);  // Initialize EEPROM with 512 bytes
    EEPROM.get(0, data);
  #endif

  if (data.magic == EEPROM_MAGIC) {
    FAN_ON_THRESHOLD = data.fanOnThreshold;
    FAN_OFF_THRESHOLD = data.fanOffThreshold;
    HEATER_ON_THRESHOLD = data.heaterOnThreshold;
    HEATER_OFF_THRESHOLD = data.heaterOffThreshold;

    Serial.println(F("\n=== Loaded thresholds from EEPROM ==="));
    Serial.print(F("  Fan ON:  ")); Serial.print(FAN_ON_THRESHOLD, 4); Serial.println(F("A"));
    Serial.print(F("  Fan OFF: ")); Serial.print(FAN_OFF_THRESHOLD, 4); Serial.println(F("A"));
    Serial.print(F("  Heat ON: ")); Serial.print(HEATER_ON_THRESHOLD, 4); Serial.println(F("A"));
    Serial.print(F("  Heat OFF:")); Serial.print(HEATER_OFF_THRESHOLD, 4); Serial.println(F("A"));
    Serial.println(F("=======================================\n"));
    return true;
  }

  Serial.println(F("No learned thresholds found, using defaults"));
  return false;
}

// Save thresholds to EEPROM
void saveThresholdsToEEPROM() {
  ThresholdData data;
  data.magic = EEPROM_MAGIC;
  data.fanOnThreshold = FAN_ON_THRESHOLD;
  data.fanOffThreshold = FAN_OFF_THRESHOLD;
  data.heaterOnThreshold = HEATER_ON_THRESHOLD;
  data.heaterOffThreshold = HEATER_OFF_THRESHOLD;

  #ifdef BOARD_SAMD21
    thresholdStorage.write(data);
  #else  // RP2040
    EEPROM.put(0, data);
    EEPROM.commit();  // RP2040 requires explicit commit
  #endif

  Serial.println(F("\n=== Saved thresholds to EEPROM ==="));
  Serial.print(F("  Fan ON:  ")); Serial.print(FAN_ON_THRESHOLD, 4); Serial.println(F("A"));
  Serial.print(F("  Fan OFF: ")); Serial.print(FAN_OFF_THRESHOLD, 4); Serial.println(F("A"));
  Serial.print(F("  Heat ON: ")); Serial.print(HEATER_ON_THRESHOLD, 4); Serial.println(F("A"));
  Serial.print(F("  Heat OFF:")); Serial.print(HEATER_OFF_THRESHOLD, 4); Serial.println(F("A"));
  Serial.println(F("===================================\n"));
}

// Load servo travel limits saved from jog mode
bool loadServoLimitsFromEEPROM() {
  ServoLimitsData data;

  #ifdef BOARD_SAMD21
    data = servoLimitsStorage.read();
  #else  // RP2040
    EEPROM.begin(512);  // Safe to call again; re-reads the same flash sector
    EEPROM.get(SERVO_LIMITS_EEPROM_ADDR, data);
  #endif

  if (data.magic == SERVO_LIMITS_MAGIC &&
      data.closedDeg >= 0 && data.closedDeg <= 180 &&
      data.openDeg >= 0 && data.openDeg <= 180 &&
      data.closedDeg != data.openDeg) {
    g_servoLimitsSaved = true;
    g_savedClosedDeg = data.closedDeg;
    g_savedOpenDeg = data.openDeg;
    Serial.print(F("Loaded servo limits: CLOSED "));
    Serial.print(g_savedClosedDeg);
    Serial.print(F(" deg, OPEN "));
    Serial.print(g_savedOpenDeg);
    Serial.println(F(" deg"));
    return true;
  }

  g_servoLimitsSaved = false;
  Serial.println(F("No saved servo limits, using hardware defaults"));
  return false;
}

// Save servo travel limits (or clear them when valid == false)
void saveServoLimitsToEEPROM(bool valid) {
  ServoLimitsData data;
  data.magic = valid ? SERVO_LIMITS_MAGIC : 0;
  data.closedDeg = valid ? g_savedClosedDeg : 0;
  data.openDeg = valid ? g_savedOpenDeg : 0;

  #ifdef BOARD_SAMD21
    servoLimitsStorage.write(data);
  #else  // RP2040
    EEPROM.begin(512);
    EEPROM.put(SERVO_LIMITS_EEPROM_ADDR, data);
    EEPROM.commit();
  #endif

  g_servoLimitsSaved = valid;
}

// ----------------- Jog Mode -----------------
// Lets the user step the servo slowly to find each hard stop, back off,
// and save the extents so normal moves never drive into the stops.

void printJogHelp() {
  Serial.println(F("Jog commands:"));
  Serial.println(F("  + / -    Step 1 degree"));
  Serial.println(F("  > / <    Step 5 degrees"));
  Serial.println(F("  0-180    Go to angle (then Enter)"));
  Serial.println(F("  C        Mark current angle as CLOSED limit"));
  Serial.println(F("  O        Mark current angle as OPEN limit"));
  Serial.println(F("  W        Write (save) marked limits and exit"));
  Serial.println(F("  Q        Quit without saving"));
  Serial.println(F("  A        Auto-find both stops (marks limits ~13% of travel short)"));
  Serial.println(F("  D        Delete saved limits and exit"));
  Serial.println(F("  F        Read feedback"));
  Serial.println(F("  H        Show this help"));
  Serial.println(F("Jogging by hand: find each stop, then back off 10-15 degrees BEFORE marking it."));
}

void enterJogMode() {
  if (g_learningPhase != LEARN_NONE) {
    Serial.println(F("Finish learning mode before jogging."));
    return;
  }
  if (!g_systemOn) {
    Serial.println(F("Wake from standby before jogging."));
    return;
  }

  g_jogMode = true;
  g_jogClosedDeg = -1;
  g_jogOpenDeg = -1;
  g_jogLastDir = 0;
  g_jogNoMoveCount = 0;
  setLEDPattern(LED_FAST_FLASH);

  Serial.println(F("\n========================================"));
  Serial.println(F("JOG MODE - automatic vent control paused"));
  Serial.println(F("========================================"));
  Serial.print(F("Current limits: CLOSED "));
  Serial.print(SERVO_CLOSED_DEG);
  Serial.print(F(" deg, OPEN "));
  Serial.print(SERVO_OPEN_DEG);
  Serial.println(g_servoLimitsSaved ? F(" deg (saved)") : F(" deg (defaults)"));
  printJogHelp();

  // Start from mid-travel. The last commanded angle may be past a hard stop
  // (calibration drives into the stops when no limits are saved), and jogging
  // from there would hold the servo stalled until it was stepped back far enough.
  Serial.println(F("Moving to 90 deg (mid-travel) to start..."));
  if (!servo.attached()) {
    servo.attach(SERVO_PWM_PIN);
  }
  g_servoDeg = 90;
  servo.write(g_servoDeg);
  delay(800);
  measureFreeSlope();  // Ends back at 90 deg
  g_jogLastFb = readServoFeedback01();
  Serial.print(F("Jog: "));
  Serial.print(g_servoDeg);
  Serial.print(F(" deg | feedback "));
  Serial.println(g_jogLastFb, 4);
}

// Move to an absolute angle in jog mode and report whether the servo actually moved
void jogTo(int deg) {
  if (deg < 0) deg = 0;
  if (deg > 180) deg = 180;
  int delta = deg - g_servoDeg;
  if (delta == 0) {
    Serial.println(F("Jog: already at end of servo range"));
    return;
  }

  servo.write(deg);
  g_servoDeg = deg;
  delay(min(150 + 8 * abs(delta), 1500));  // Small steps settle quickly

  float fb = readServoFeedback01();
  float dFb = fb - g_jogLastFb;
  g_jogLastFb = fb;

  Serial.print(F("Jog: "));
  Serial.print(deg);
  Serial.print(F(" deg | feedback "));
  Serial.print(fb, 4);
  Serial.print(F(" (change "));
  if (dFb >= 0) Serial.print('+');
  Serial.print(dFb, 4);
  Serial.println(F(")"));

  // A feedback servo's pot is on the output shaft, so if the commanded angle
  // changes but the feedback doesn't, the output is blocked by a stop.
  // Expected change per degree comes from the last calibration.
  if (g_fbPerDeg == 0.0f) return;  // Slope unknown - nothing to compare against
  float expected = fabsf(g_fbPerDeg) * abs(delta);

  int dir = (delta > 0) ? 1 : -1;
  if (dir != g_jogLastDir) g_jogNoMoveCount = 0;
  g_jogLastDir = dir;

  if (fabsf(dFb) < 0.35f * expected) {
    g_jogNoMoveCount++;
    // One small step can fall inside the servo's deadband, so wait for two
    if (g_jogNoMoveCount >= 2 || abs(delta) >= 5) {
      Serial.println(F("!! Feedback is not following - likely AT A STOP. Back off 2-3 deg, then mark."));
    }
  } else {
    g_jogNoMoveCount = 0;
  }
}

// Measure feedback change per commanded degree over free mid-travel (70-100 deg).
// Both readings are approached from the same direction so gear slack doesn't skew them.
// Leaves the servo at 90 deg.
bool measureFreeSlope() {
  servo.write(70);
  delay(500);
  servo.write(80);
  delay(400);
  float fb80 = readServoFeedback01();
  servo.write(100);
  delay(500);
  float fb100 = readServoFeedback01();
  servo.write(90);
  g_servoDeg = 90;
  delay(400);

  g_fbPerDeg = (fb100 - fb80) / 20.0f;
  Serial.print(F("Free travel: "));
  Serial.print(g_fbPerDeg, 5);
  Serial.println(F(" feedback per deg"));
  if (fabsf(g_fbPerDeg) < 0.0003f) {
    g_fbPerDeg = 0.0f;
    Serial.println(F("WARNING: Feedback not following the servo - stop detection disabled"));
    return false;
  }
  return true;
}

// Creep from 90 deg in direction dir (+1/-1) until the shaft falls behind the
// command (blocked by a stop) or the servo runs out of range. Returns the angle
// the shaft actually stopped at (or the end of servo range), then moves back to 90 deg.
int findStop(int dir) {
  // Take up gear slack in the travel direction before taking the reference
  servo.write(90 - dir * 5);
  delay(300);
  servo.write(90);
  delay(400);

  int deg = 90;
  int refDeg = 90;                       // Last angle where the shaft was keeping up
  float refFb = readServoFeedback01();
  float lagDeg = 0.0f;
  uint8_t lagCount = 0;
  bool hitStop = false;

  while (deg + dir * 2 >= 0 && deg + dir * 2 <= 180) {
    deg += dir * 2;
    servo.write(deg);
    delay(120);
    float fb = readServoFeedback01();

    // How far the shaft is behind where it should be, in degrees
    float movedDeg = (fb - refFb) / g_fbPerDeg;
    lagDeg = (float)(deg - refDeg) * dir - movedDeg * dir;

    if (lagDeg > STOP_LAG_DEG) {
      if (++lagCount >= 2) {
        hitStop = true;
        break;
      }
    } else {
      lagCount = 0;
      if (lagDeg < 1.5f) {
        refDeg = deg;
        refFb = fb;
      }
    }
  }

  int stopDeg = hitStop ? deg - dir * (int)(lagDeg + 0.5f) : deg;

  // Unload the stop right away
  servo.write(90);
  g_servoDeg = 90;
  delay(600);

  if (hitStop) {
    Serial.print(F("  Stop found at about "));
    Serial.print(stopDeg);
    Serial.println(F(" deg"));
  } else {
    Serial.print(F("  No stop before the end of servo range ("));
    Serial.print(stopDeg);
    Serial.println(F(" deg)"));
  }
  return stopDeg;
}

// Find both stops and mark limits SERVO_STOP_BACKOFF_PCT of the travel short of each.
// Nothing is saved until the user sends W.
bool autoFindStops() {
  Serial.println(F("\n--- AUTO-FIND STOPS ---"));
  if (g_fbPerDeg == 0.0f && !measureFreeSlope()) {
    Serial.println(F("Auto-find needs working feedback. Jog by hand instead."));
    return false;
  }

  int closedDir = (DEFAULT_CLOSED_DEG > DEFAULT_OPEN_DEG) ? 1 : -1;
  Serial.println(F("Finding CLOSED stop..."));
  int closedStop = findStop(closedDir);
  Serial.println(F("Finding OPEN stop..."));
  int openStop = findStop(-closedDir);
  g_jogLastFb = readServoFeedback01();

  // Pull each limit in toward the middle by the same share of the travel
  int travel = abs(closedStop - openStop);
  int backoff = (int)(travel * SERVO_STOP_BACKOFF_PCT / 100.0f + 0.5f);
  g_jogClosedDeg = closedStop - closedDir * backoff;
  g_jogOpenDeg = openStop + closedDir * backoff;
  Serial.print(F("Travel "));
  Serial.print(travel);
  Serial.print(F(" deg, backing off "));
  Serial.print(backoff);
  Serial.print(F(" deg ("));
  Serial.print(SERVO_STOP_BACKOFF_PCT, 1);
  Serial.println(F("%) from each end"));

  Serial.print(F("\nMarked CLOSED "));
  Serial.print(g_jogClosedDeg);
  Serial.print(F(" deg, OPEN "));
  Serial.print(g_jogOpenDeg);
  Serial.println(F(" deg (not saved yet)"));
  if (g_jogMode) {
    Serial.println(F("Check them by typing either angle + Enter. Adjust with jog + C/O if needed."));
    Serial.println(F("W to save, Q to cancel."));
  }
  return abs(g_jogOpenDeg - g_jogClosedDeg) >= 10;
}

// First-time setup when no limits are saved: find the stops and save them.
// The user can redo this later with A, set them by hand with J, or delete them with D.
bool autoSetupServo() {
  Serial.println(F("No saved servo limits - running automatic setup"));
  if (!servo.attached()) {
    servo.attach(SERVO_PWM_PIN);
  }
  servo.write(90);
  g_servoDeg = 90;
  delay(800);

  if (!measureFreeSlope() || !autoFindStops()) {
    servo.detach();
    Serial.println(F("Automatic setup failed - set the limits from the console (A or J)"));
    return false;
  }

  g_savedClosedDeg = g_jogClosedDeg;
  g_savedOpenDeg = g_jogOpenDeg;
  saveServoLimitsToEEPROM(true);
  Serial.print(F("Saved servo limits: CLOSED "));
  Serial.print(g_savedClosedDeg);
  Serial.print(F(" deg, OPEN "));
  Serial.print(g_savedOpenDeg);
  Serial.println(F(" deg"));
  return true;
}

void markJogLimit(bool closed) {
  if (closed) g_jogClosedDeg = g_servoDeg;
  else g_jogOpenDeg = g_servoDeg;
  Serial.print(closed ? F("CLOSED") : F("OPEN"));
  Serial.print(F(" limit marked at "));
  Serial.print(g_servoDeg);
  Serial.println(F(" deg (not saved yet - W to save)"));
}

// Leave jog mode, then recalibrate feedback at whichever limits are now active
void exitJogMode() {
  g_jogMode = false;
  servo.detach();
  calibrateFromCurrentPosition();  // Moves closed -> open -> closed using the active limits
  g_ventOpen = false;
  g_ventClosePending = false;
  setLEDPattern(g_servoLimitsSaved ? LED_SOLID : LED_DOUBLE_BLINK);
  Serial.println(F("Jog mode ended - automatic vent control resumed\n"));
}

void saveJogLimitsAndExit() {
  if (g_jogClosedDeg < 0 || g_jogOpenDeg < 0) {
    Serial.println(F("Mark both CLOSED (C) and OPEN (O) before saving."));
    return;
  }
  if (abs(g_jogOpenDeg - g_jogClosedDeg) < 10) {
    Serial.println(F("CLOSED and OPEN must be at least 10 degrees apart."));
    return;
  }

  g_savedClosedDeg = g_jogClosedDeg;
  g_savedOpenDeg = g_jogOpenDeg;
  saveServoLimitsToEEPROM(true);
  Serial.print(F("\nSaved servo limits: CLOSED "));
  Serial.print(g_savedClosedDeg);
  Serial.print(F(" deg, OPEN "));
  Serial.print(g_savedOpenDeg);
  Serial.println(F(" deg"));
  exitJogMode();
}

void handleJogCommand(char ch) {
  switch (ch) {
    case '+': case '=': jogTo(g_servoDeg + 1); break;
    case '-': case '_': jogTo(g_servoDeg - 1); break;
    case '>': case '.': jogTo(g_servoDeg + 5); break;
    case '<': case ',': jogTo(g_servoDeg - 5); break;
    case 'C': case 'c': markJogLimit(true); break;
    case 'O': case 'o': markJogLimit(false); break;
    case 'W': case 'w': saveJogLimitsAndExit(); break;
    case 'Q': case 'q':
      Serial.println(F("\nJog cancelled - limits unchanged"));
      exitJogMode();
      break;
    case 'A': case 'a': autoFindStops(); break;
    case 'D': case 'd':
      saveServoLimitsToEEPROM(false);
      Serial.println(F("\nSaved limits deleted - using hardware defaults"));
      exitJogMode();
      break;
    case 'F': case 'f':
      Serial.print(F("Jog: "));
      Serial.print(g_servoDeg);
      Serial.print(F(" deg | feedback "));
      Serial.println(readServoFeedback01(), 4);
      break;
    case 'H': case 'h': case '?': printJogHelp(); break;
    default: break;  // Ignore stray characters (spaces, etc.)
  }
}

// Start learning mode
void startLearningMode() {
  Serial.println(F("\n========================================"));
  Serial.println(F("ENTERING LEARNING MODE"));
  Serial.println(F("========================================"));
  Serial.println(F("This will learn optimal thresholds"));
  Serial.println(F(""));
  Serial.println(F("LED patterns:"));
  Serial.println(F("  FLASHING = Measuring now (don't touch)"));
  Serial.println(F("  SOLID = Waiting - make change, press button"));
  Serial.println(F("  3 LONG BLINKS = All done!"));
  Serial.println(F(""));
  Serial.println(F("PHASE 1: Ensure dryer is completely OFF"));
  Serial.println(F("Press button when ready..."));
  Serial.println(F("========================================\n"));

  g_learningPhase = LEARN_BASELINE;
  g_learnedBaseline = 0.0f;
  g_learnedHeater = 0.0f;
  g_learnedFanOnly = 0.0f;
  g_learningStartMs = 0;  // Not measuring yet
  g_learningPhaseEntryMs = millis();

  // Start with solid LED - waiting for user to press button
  setLEDPattern(LED_SOLID);
}

// Process learning phase
void processLearningPhase() {
  uint32_t now = millis();

  // Check if we're in learning mode
  if (g_learningPhase != LEARN_NONE) {
    // Update LED pattern
    updateLEDPattern();

    // Check if measurement period started
    if (g_learningStartMs > 0) {
      if (now - g_learningStartMs >= LEARNING_MEASURE_MS) {
        // Measurement complete - stop measuring and wait for user
        g_learningStartMs = 0;

        // Move to next phase
        switch (g_learningPhase) {
          case LEARN_BASELINE:
            Serial.print(F("Baseline learned: "));
            Serial.print(g_learnedBaseline, 4);
            Serial.println(F("A\n"));

            g_learningPhase = LEARN_HEATER;
            setLEDPattern(LED_SOLID);
            Serial.println(F("PHASE 2: Turn dryer ON (heater + fan)"));
            Serial.println(F("Press button when ready..."));
            break;

          case LEARN_HEATER:
            Serial.print(F("Heater+Fan learned: "));
            Serial.print(g_learnedHeater, 4);
            Serial.println(F("A\n"));

            g_learningPhase = LEARN_FAN_ONLY;
            setLEDPattern(LED_SOLID);
            Serial.println(F("PHASE 3: Turn heater OFF (fan only)"));
            Serial.println(F("Press button when ready..."));
            break;

          case LEARN_FAN_ONLY:
            Serial.print(F("Fan only learned: "));
            Serial.print(g_learnedFanOnly, 4);
            Serial.println(F("A\n"));

            // Calculate optimal thresholds
            Serial.println(F("Calculating thresholds..."));

            // Fan threshold = halfway between baseline and fan-only
            FAN_ON_THRESHOLD = (g_learnedBaseline + g_learnedFanOnly) / 2.0f + 0.002f;  // Add 2mA margin
            FAN_OFF_THRESHOLD = FAN_ON_THRESHOLD - 0.005f;  // 5mA hysteresis

            // Heater threshold = halfway between fan-only and heater
            // Heat OFF must sit ABOVE fan-only current so it trips when heater stops but fan continues
            HEATER_ON_THRESHOLD = (g_learnedFanOnly + g_learnedHeater) / 2.0f;
            HEATER_OFF_THRESHOLD = g_learnedFanOnly + (g_learnedHeater - g_learnedFanOnly) * 0.25f;

            // Save to EEPROM
            saveThresholdsToEEPROM();

            // Show completion blink
            g_learningPhase = LEARN_COMPLETE;
            setLEDPattern(LED_COMPLETE_BLINK);
            Serial.println(F("========================================"));
            Serial.println(F("LEARNING COMPLETE!"));
            Serial.println(F("Thresholds saved to EEPROM"));
            Serial.println(F("========================================\n"));

            delay(3500);  // Wait for complete blink

            // Return to normal operation
            g_learningPhase = LEARN_NONE;
            setLEDPattern(LED_SOLID);
            break;

          default:
            break;
        }
      } else {
        // Still measuring - accumulate current reading
        float Irms = measureIrmsOver(SAMPLE_MS);

        switch (g_learningPhase) {
          case LEARN_BASELINE:
            // Running average
            if (g_learnedBaseline == 0.0f) {
              g_learnedBaseline = Irms;
            } else {
              g_learnedBaseline = g_learnedBaseline * 0.9f + Irms * 0.1f;
            }
            break;

          case LEARN_HEATER:
            // Take maximum reading (heater may cycle)
            if (Irms > g_learnedHeater) {
              g_learnedHeater = Irms;
            }
            break;

          case LEARN_FAN_ONLY:
            // Running average
            if (g_learnedFanOnly == 0.0f) {
              g_learnedFanOnly = Irms;
            } else {
              g_learnedFanOnly = g_learnedFanOnly * 0.9f + Irms * 0.1f;
            }
            break;

          default:
            break;
        }

        // Print progress every second
        static uint32_t lastProgress = 0;
        if (now - lastProgress >= 1000) {
          uint32_t remaining = (LEARNING_MEASURE_MS - (now - g_learningStartMs)) / 1000;
          Serial.print(F("  Measuring... "));
          Serial.print(remaining);
          Serial.print(F("s remaining ("));
          Serial.print(Irms, 4);
          Serial.println(F("A)"));
          lastProgress = now;
        }
      }
    }
  }
}

// Handle learning mode button press
void handleLearningButtonPress() {
  if (g_learningPhase != LEARN_NONE && g_learningPhase != LEARN_COMPLETE) {
    if (g_learningStartMs == 0) {
      // Start measurement - switch to flashing LED
      Serial.println(F("Starting measurement..."));
      g_learningStartMs = millis();
      setLEDPattern(LED_FAST_FLASH);
    }
  }
}

// Print the serial command menu (at startup and on '?')
void printCommandMenu() {
  Serial.println(F("Serial Commands:"));
  Serial.println(F("  O or o - Open vent"));
  Serial.println(F("  C or c - Close vent"));
  Serial.println(F("  R or r - Recalibrate servo only"));
  Serial.println(F("  F or f - Read current feedback (no movement)"));
  Serial.println(F("  S or s - Toggle standby mode"));
  Serial.println(F("  L or l - Enter learning mode"));
  Serial.println(F("  N or n - Next (advance learning mode phase)"));
  Serial.println(F("  T or t - Run ACS758 connectivity self-test"));
  Serial.println(F("  0-180  - Move servo to specified degrees"));
  Serial.println(F("  A or a - Servo setup: auto-find the stops (then W to save)"));
  Serial.println(F("  J or j - Servo setup: jog by hand to find the stops"));
  Serial.println(F("  ?      - Show this menu"));
  Serial.println(F("Button:"));
  Serial.println(F("  Short press       - Full recalibration"));
  Serial.println(F("  Long press 2s     - Toggle standby/wake"));
  Serial.println(F("  Very long press 5s - Enter learning mode"));
  Serial.println(F("========================================\n"));
}

// ----------------- Setup -----------------
void setup() {
  // Initialize LED and button pins first
  #ifdef BOARD_RP2040
    // CRITICAL: RP2040 requires explicit GPIO function setup
    // GPIO3 (D10) defaults to SPI MOSI, must set to GPIO mode
    // GPIO26 (D0) needs PWM function for servo
    // GPIO29 (D3) needs GPIO mode for button
    gpio_set_function(GPIO_LED, GPIO_FUNC_SIO);    // D10/GPIO3 to GPIO mode
    gpio_set_function(GPIO_SERVO, GPIO_FUNC_PWM);  // D0/GPIO26 to PWM mode
    gpio_set_function(GPIO_BTN, GPIO_FUNC_SIO);    // D3/GPIO29 to GPIO mode

    // Set maximum drive strength for LED (makes it brighter)
    gpio_set_drive_strength(GPIO_LED, GPIO_DRIVE_STRENGTH_12MA);
    gpio_set_slew_rate(GPIO_LED, GPIO_SLEW_RATE_FAST);
  #endif

  pinMode(LED_PIN, OUTPUT);
  pinMode(BUTTON_PIN, INPUT_PULLUP);
  #ifdef BOARD_SAMD21
    pinMode(LED_BUILTIN, OUTPUT);
  #endif
  digitalWrite(LED_PIN, LOW);  // LED off initially

  #ifdef BOARD_RP2040
    // Initialize NeoPixel power and breathing effect
    pinMode(NEOPIXEL_POWER_PIN, OUTPUT);
    digitalWrite(NEOPIXEL_POWER_PIN, HIGH);  // Power on the NeoPixel
    neopixel.begin();
    neopixel.setBrightness(255);  // Full brightness control in code
    neopixel.show(); // Initialize all pixels to 'off'
    g_breathingStartMs = millis();
  #else
    digitalWrite(LED_BUILTIN, LOW);  // LED off Initially (SAMD21)
  #endif

  Serial.begin(115200);

  // Wait for Serial with timeout
  uint32_t serialTimeout = millis();
  while (!Serial && (millis() - serialTimeout < 3000)) { }

  Serial.println(F("\n\n========================================"));
  Serial.println(F("SUNLU AMS Heater Auto-Vent Controller"));
  Serial.print(F("Firmware Version: "));
  Serial.println(F(FIRMWARE_VERSION));
  Serial.print(F("Build Date: "));
  Serial.print(F(FIRMWARE_DATE));
  Serial.print(F(" "));
  Serial.println(F(FIRMWARE_TIME));
  Serial.print(F("Hardware Version: "));
  Serial.println(HARDWARE_VERSION);
  Serial.print(F("Board: Seeed XIAO "));
  Serial.println(F(MY_BOARD_NAME));
  Serial.println(F("ADS1115 + ACS758 + Servo"));
  Serial.println(F("========================================\n"));

  Serial.println(F("Initializing ADS1115..."));
  if (!ads.begin()) {
    Serial.println(F("ERROR: ADS1115 not found! Check I2C wiring."));
    while(1) {
      delay(1000);
      Serial.println(F("ERROR: ADS1115 not found!"));
    }
  }

  ads.setGain(GAIN_ONE);  // ±4.096V range
  ads.setDataRate(RATE_ADS1115_128SPS);  // 128 samples per second
  Serial.println(F("ADS1115 initialized successfully\n"));

  // Verify the ACS758 is actually wired to the ADC before we trust any reading.
  // This is advisory: a bad verdict is reported but does not halt the system,
  // so a false positive can never brick a working dryer.
  g_acsTestResult = runAcsSelfTest(true);
  if (g_acsTestResult >= ACS_FAIL_FLOATING) {
    Serial.println(F("*** ACS758 SELF-TEST FAILED - current readings are NOT trustworthy ***"));
    Serial.println(F("*** Fix the wiring, then press the button or send 'T' to retest.   ***\n"));
    setLEDPattern(LED_FAST_FLASH);
    delayWithFlashing(3000);
  }

  // Load learned thresholds from EEPROM (if available)
  loadThresholdsFromEEPROM();

  // Load servo travel limits set in jog mode (if available)
  loadServoLimitsFromEEPROM();

  // Run full calibration (servo + current offset)
  runFullCalibration();

  printCommandMenu();

  g_lastUpdateMs = millis();
  setLEDPattern(g_servoLimitsSaved ? LED_SOLID : LED_DOUBLE_BLINK);
}

// ----------------- Loop -----------------
void loop() {
  static bool longPressExecuted = false;  // Declare at function scope
  uint32_t now = millis();

  // Check for button press FIRST (before learning mode processing)
  bool currentButtonState = digitalRead(BUTTON_PIN);
  if (g_jogMode) currentButtonState = g_lastButtonState;  // Button is ignored while jogging

  // Button just pressed - start timing
  if (currentButtonState == LOW && g_lastButtonState == HIGH) {
    g_buttonPressStart = now;
    g_buttonHandled = false;
  }

  // Button is being held - check for very long press first, then long press
  // Skip long/very long press detection if already in learning mode
  if (currentButtonState == LOW && g_learningPhase == LEARN_NONE) {
    uint32_t pressDuration = now - g_buttonPressStart;

    // Check for very long press (>5s) - takes priority, overrides long press
    if (pressDuration >= VLONG_PRESS_MS) {
      if (!g_buttonHandled) {
        g_buttonHandled = true;  // Prevent repeated triggers
        Serial.println(F("\n*** VERY LONG PRESS DETECTED ***"));

        // Cancel standby if it was triggered
        if (!g_systemOn) {
          g_systemOn = true;
          setLEDPattern(LED_FAST_FLASH);
        }

        startLearningMode();
        g_ignoreNextRelease = true;  // Ignore the button release after entering learning mode
      }
    }
    // Check for long press (2s) - but only if very long press hasn't been handled yet
    else if (pressDuration >= LONG_PRESS_MS && !g_buttonHandled) {
      // Don't mark as handled yet - allow very long press to override
      // Just execute the long press action once
      if (!longPressExecuted) {
        longPressExecuted = true;

        if (g_systemOn) {
          // System is ON - enter standby mode
          Serial.println(F("\n*** LONG PRESS DETECTED ***"));
          enterStandbyMode();
        } else {
          // System is OFF - wake up with full calibration
          Serial.println(F("\n*** LONG PRESS DETECTED ***"));
          Serial.println(F("Waking up from standby..."));
          runFullCalibration();
        }
      }
    }
  }

  // Reset long press executed flag when button is released
  if (currentButtonState == HIGH && g_lastButtonState == LOW) {
    longPressExecuted = false;
  }

  // Button just released - check for short press
  if (currentButtonState == HIGH && g_lastButtonState == LOW) {
    // Check if we're in learning mode waiting for button press
    if (g_learningPhase != LEARN_NONE) {
      // Ignore the first button release after entering learning mode
      if (g_ignoreNextRelease) {
        Serial.println(F("Ignoring button release from learning mode entry"));
        g_ignoreNextRelease = false;
      } else {
        Serial.println(F("Button released during learning mode"));
        handleLearningButtonPress();
      }
    } else if (!g_buttonHandled) {
      // Short press detected (released before long press threshold)
      Serial.println(F("\n*** SHORT PRESS DETECTED ***"));
      Serial.println(F("Running recalibration..."));
      runFullCalibration();
    }
  }

  g_lastButtonState = currentButtonState;

  // Check for serial commands (MUST be before learning mode processing to allow 'N' command)
  while (Serial.available()) {
    char ch = Serial.read();

    // Handle newline - process buffered command
    if (ch == '\n' || ch == '\r') {
      if (g_serialIdx > 0) {
        g_serialBuffer[g_serialIdx] = '\0';  // Null terminate

        // Check if it's a number
        bool isNumber = true;
        for (uint8_t i = 0; i < g_serialIdx; i++) {
          if (!isdigit(g_serialBuffer[i])) {
            isNumber = false;
            break;
          }
        }

        if (isNumber) {
          int degrees = atoi(g_serialBuffer);
          if (degrees >= 0 && degrees <= 180) {
            if (g_jogMode) {
              jogTo(degrees);  // Servo stays attached and reports feedback
            } else {
              Serial.print(F("Moving to "));
              Serial.print(degrees);
              Serial.println(F(" degrees..."));
              moveServo(degrees);

              // Read and display feedback at new position
              delay(100);
              float fb = readServoFeedback01();
              Serial.print(F("Feedback at position: "));
              Serial.println(fb, 4);
            }
          } else {
            Serial.println(F("Invalid degrees (use 0-180)"));
          }
        }
        g_serialIdx = 0;  // Reset buffer
      }
    }
    // Handle single character commands immediately
    else if (g_serialIdx == 0 && !isdigit(ch)) {
      if (g_jogMode) {
        handleJogCommand(ch);
      } else if (ch == '?') {
        printCommandMenu();
      } else if (ch == 'J' || ch == 'j') {
        enterJogMode();
      } else if (ch == 'A' || ch == 'a') {
        enterJogMode();
        if (g_jogMode) autoFindStops();
      } else if (ch == 'O' || ch == 'o') {
        openVent();
      } else if (ch == 'C' || ch == 'c') {
        closeVent();
      } else if (ch == 'R' || ch == 'r') {
        calibrateFromCurrentPosition();
      } else if (ch == 'F' || ch == 'f') {
        // Just read feedback without moving anything
        float fb = readServoFeedback01();
        Serial.print(F("Current feedback: "));
        Serial.print(fb, 4);
        Serial.print(F(" = "));
        Serial.print(feedbackToDeg(fb));
        Serial.println(F(" degrees (calibrated)"));
      } else if (ch == 'S' || ch == 's') {
        // Toggle standby mode
        if (g_systemOn) {
          enterStandbyMode();
        } else {
          Serial.println(F("\nWaking up from standby..."));
          runFullCalibration();
        }
      } else if (ch == 'L' || ch == 'l') {
        // Enter learning mode
        startLearningMode();
      } else if (ch == 'N' || ch == 'n') {
        // Next/advance learning mode (simulate button press)
        if (g_learningPhase != LEARN_NONE && g_learningPhase != LEARN_COMPLETE) {
          Serial.println(F("\n*** SERIAL COMMAND: Advancing learning phase ***"));
          handleLearningButtonPress();
        } else if (g_learningPhase == LEARN_NONE) {
          Serial.println(F("Not in learning mode. Send 'L' first."));
        } else {
          Serial.println(F("Learning already complete."));
        }
      } else if (ch == 'T' || ch == 't') {
        g_acsTestResult = runAcsSelfTest(true);
      }
    }
    // Buffer digits for numeric input
    else if (isdigit(ch) && g_serialIdx < sizeof(g_serialBuffer) - 1) {
      g_serialBuffer[g_serialIdx++] = ch;
    }
  }

  // Jog mode pauses all automatic control
  if (g_jogMode) {
    updateLEDPattern();
    return;
  }

  // Handle learning mode processing (if active)
  if (g_learningPhase != LEARN_NONE) {
    processLearningPhase();
    return;  // Skip normal operation when in learning mode
  }

  // Update LED pattern (handles all LED states now)
  updateLEDPattern();

  // Update built-in LED breathing effect (RP2040 only)
  #ifdef BOARD_RP2040
    if (g_systemOn) {  // Only breathe when system is active
      updateBuiltinLEDBreathing();
    } else {
      neopixel.setPixelColor(0, 0);  // Turn off in standby
      neopixel.show();
    }
  #endif

  // Skip all monitoring when in standby mode
  if (!g_systemOn) {
    delay(100);
    return;
  }

  // Only update and display every 5 seconds
  if (now - g_lastUpdateMs >= 5000) {
    g_lastUpdateMs = now;

    // Measure current
    float Irms = measureIrmsOver(SAMPLE_MS);

    // Add to rolling average buffer
    addSampleToRollingAvg(Irms);

    // Calculate rolling average
    float rollingAvgIrms = getRollingAverage();

    // Determine fan state (informational only - may not be accurate)
    // Uses global g_fanOn variable with hysteresis
    if (Irms >= FAN_ON_THRESHOLD) {
      g_fanOn = true;
    } else if (Irms <= FAN_OFF_THRESHOLD) {
      g_fanOn = false;
    }

    // Determine heater state (informational only - may not distinguish low heat from fan)
    // Uses global g_heaterOn variable with hysteresis
    if (Irms >= HEATER_ON_THRESHOLD) {
      g_heaterOn = true;
    } else if (Irms <= HEATER_OFF_THRESHOLD) {
      g_heaterOn = false;
    }

    // Simple activity detection (use this for vent control)
    // Uses global g_systemActive variable with hysteresis
    if (Irms >= ACTIVITY_THRESHOLD) {
      g_systemActive = true;
    } else if (Irms <= IDLE_THRESHOLD) {
      g_systemActive = false;
    }

    // Vent control logic based on heater and fan state
    // Debug: show state before decision
    Serial.print(F("DEBUG: heaterOn="));
    Serial.print(g_heaterOn);
    Serial.print(F(" fanOn="));
    Serial.print(g_fanOn);
    Serial.print(F(" g_ventOpen="));
    Serial.print(g_ventOpen);
    Serial.print(F(" Irms="));
    Serial.println(Irms, 4);

    if (!g_servoLimitsSaved) {
      // Servo travel limits not set up yet - never drive the vent automatically
    } else if (g_heaterOn && !g_ventOpen) {
      // Heater is ON and vent is closed - open it, cancel any pending close
      g_ventClosePending = false;
      Serial.println(F(">>> HEATER ON - Opening vent"));
      openVent();
      g_ventOpen = true;
    } else if (!g_heaterOn && !g_fanOn && g_ventOpen) {
      // Both heater AND fan are OFF - close immediately
      Serial.println(F(">>> HEATER & FAN OFF - Closing vent immediately"));
      closeVent();
      g_ventOpen = false;
      g_ventClosePending = false;
    } else if (!g_heaterOn && g_heaterWasOn && g_fanOn && g_ventOpen) {
      // Heater just turned OFF but fan still running - start delay timer
      g_ventCloseDelayStart = now;
      g_ventClosePending = true;
      Serial.println(F(">>> HEATER OFF, FAN ON - Vent close in 3min"));
    }
    g_heaterWasOn = g_heaterOn;

    // Check if pending close delay has expired (fan still running case)
    if (g_ventClosePending && !g_heaterOn && g_fanOn) {
      uint32_t elapsed = now - g_ventCloseDelayStart;
      if (elapsed >= VENT_CLOSE_DELAY_MS) {
        Serial.println(F("DELAY EXPIRED - Closing vent"));
        closeVent();
        g_ventOpen = false;
        g_ventClosePending = false;
      }
    }

    // Display debug information - throttled to once every 5 seconds
    if (now - g_lastDebugOutputMs >= 5000) {
      g_lastDebugOutputMs = now;

      float rawV = readVolts(ADS_CH_CURRENT);
      Serial.print(now / 1000);
      Serial.print(F("s | Offset: "));
      Serial.print(g_voltageOffset, 4);
      Serial.print(F("V | Raw: "));
      Serial.print(rawV, 4);
      Serial.print(F("V | Irms: "));
      Serial.print(Irms, 4);
      Serial.print(F("A | Avg: "));
      Serial.print(rollingAvgIrms, 4);
      Serial.print(F("A ("));
      Serial.print(g_sampleCount);
      Serial.print(F("/"));
      Serial.print(MAX_SAMPLES);
      Serial.print(F(") | Fan: "));
      Serial.print(g_fanOn ? F("ON ") : F("OFF"));
      Serial.print(F(" | Heat: "));
      Serial.print(g_heaterOn ? F("ON ") : F("OFF"));
      Serial.print(F(" | Vent: "));
      Serial.print(g_ventOpen ? F("OPEN") : F("CLOSED"));
      if (!g_servoLimitsSaved) {
        Serial.print(F(" | SERVO NOT SET UP (send A)"));
      }
      if (g_ventClosePending) {
        uint32_t remaining = (VENT_CLOSE_DELAY_MS - (now - g_ventCloseDelayStart)) / 1000;
        Serial.print(F(" ("));
        Serial.print(remaining);
        Serial.print(F("s)"));
      }
      Serial.println();
      Serial.flush();  // Ensure serial buffer is emptied to prevent overflow
    }
  }

  // Small delay to prevent tight looping
  delay(100);
}
