kgregg384/SUNLU_AMS_Heater_AutoVent/(commit log)

2026-01-27 Initial commit: Add SUNLU AMS Heater AutoVent Arduino code
2026-02-02 Add learning mode, EEPROM storage, and enhanced UI features
    Major enhancements to production-ready system:
    - Self-learning threshold calibration for heater/fan detection
    - EEPROM storage for learned thresholds using FlashStorage
    - Enhanced LED patterns for user feedback (7 patterns)
    - Extended button interface (short/long/very-long press)
    - Simplified servo calibration with fixed positions
    - Comprehensive documentation and user guide
    - Adjusted default fan thresholds (25mA/20mA)
    [SUNLU_AMS_Heater_AutoVent.ino]
2026-02-02 Simplify learning mode with intuitive button-controlled flow
    Replaces complex auto-timed LED patterns with simple user-controlled process:
    - SOLID LED = waiting for user to press button
    - FAST FLASH = measuring (10 seconds)
    - 3 LONG BLINKS = complete
    Changes:
    - Remove auto-start timers - user initiates each phase with button press
    - Remove complex LED patterns (breathing, double blink, success blink)
    - User has full control over timing between phases
    - Clearer serial output instructions
    - Updated USER_GUIDE.md with simplified step-by-step process
    Benefits:
    - More intuitive for users
    - No rushing between phases
    - Clear visual feedback at each step
    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
    [SUNLU_AMS_Heater_AutoVent.ino]
2026-02-02 Fix button handling during learning mode
    Bug: Button presses during learning mode were triggering standby
    mode instead of starting measurements if held for >2 seconds.
    Fix: Skip long/very long press detection when already in learning
    mode by adding `g_learningPhase == LEARN_NONE` check.
    Now any button press during learning mode will start the measurement,
    regardless of how long the button is held.
    [SUNLU_AMS_Heater_AutoVent.ino]
2026-02-02 Fix button handling in learning mode - move before early return
    Critical fix: Button presses during learning mode were not being
    detected because learning mode check with early return was at the
    top of loop(), preventing button handling code from executing.
    - Move button handling to beginning of loop() before learning check
    - Add g_ignoreNextRelease flag to ignore button release after
    entering learning mode (prevents immediate measurement start)
    - Learning mode processing now happens after button handling
    - Added debug serial output for button events
    Now button presses during learning mode work correctly to start
    measurements for each phase.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
    [SUNLU_AMS_Heater_AutoVent.ino]
2026-02-03 Add RP2040 support with dual-board compatibility
    Implements support for both Seeed XIAO SAMD21 and XIAO RP2040 boards
    using conditional compilation to keep functionality perfectly synchronized.
    - Add board detection using ARDUINO_ARCH_SAMD/ARDUINO_ARCH_RP2040
    - Conditional includes for FlashStorage (SAMD21) and EEPROM (RP2040)
    - Board-specific EEPROM read/write implementations
    - Initialize RP2040 EEPROM with EEPROM.begin() in setup()
    - Display detected board type at startup
    - Update documentation for both boards
    Key Features:
    - Single source file supports both boards automatically
    - Pin mappings identical between boards (D0, D3, D10, I2C)
    - EEPROM storage works on both platforms
    -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
2026-02-04 Revert to SAMD21-only version
    Temporarily revert RP2040 support while investigating hardware
    compatibility issues. RP2040 has pin function conflicts (GPIO3
    defaults to SPI MOSI mode) that need to be resolved on breadboard
    before re-integrating dual-board support.
    RP2040 test code remains in RP2040_Hardware_Test/ folder.
    [SUNLU_AMS_Heater_AutoVent.ino]
2026-02-04 Add RP2040 support alongside existing SAMD21 compatibility
    - Auto-detects board type (SAMD21 vs RP2040) at compile time
    - RP2040 pin definitions use D prefix (D0, D10, D3) as required
    - SAMD21 uses numeric pins (0, 10, 3) as before
    - RP2040 GPIO initialization: sets GPIO modes and drive strength
    - GPIO3 (D10/LED) set to GPIO mode (defaults to SPI MOSI)
    - GPIO26 (D0/Servo) set to PWM mode
    - GPIO29 (D3/Button) set to GPIO mode
    - LED drive strength increased to 12mA for brightness
    - EEPROM abstraction: FlashStorage for SAMD21, EEPROM.h for RP2040
    - Added RP2040 hardware test sketch for debugging
    - Both boards compile cleanly without warnings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
2026-02-06 Add RP2040 NeoPixel RGB LED support and improve LED handling
    - Add Adafruit_NeoPixel library integration for RP2040
    - Implement breathing LED effect with color-coded heater state (RED=on, BLUE=off)
    - Add proper LED_BUILTIN conditional compilation for both boards
    - Initialize NeoPixel power and data pins on RP2040
    - Update LED pattern handler to support both external and built-in LEDs
    - Maintain full backward compatibility with SAMD21
2026-02-06 Fix LED_BUILTIN pinMode to be SAMD21-only
    Wrap pinMode(LED_BUILTIN, OUTPUT) in conditional compilation to
    prevent issues on RP2040 where LED_BUILTIN may not be properly defined.
    This matches the existing conditional usage for digitalWrite(LED_BUILTIN).
    [SUNLU_AMS_Heater_AutoVent.ino]
2026-02-13 Add HARDWARE_VERSION define for servo configuration
    - Add HARDWARE_VERSION selector at top of file (line 45)
    - Version 1: Servo open at 10°, closed at 170°
    - Version 2: Servo open at 0°, closed at 180° (current default)
    - Update servo position initialization based on version
    - Update both calibration functions to respect hardware version
    - Serial output shows which hardware version is active
    To switch versions, change line 45:
    #define HARDWARE_VERSION 1 // or 2
2026-02-13 Add Serial.flush() to prevent serial output buffer overflow
    Adds Serial.flush() after debug output every 5 seconds to ensure
    the serial buffer is emptied. This prevents buffer overflow issues
    that can cause serial output to stop while the device continues
    to function normally.
    Helps prevent issues on Mac where USB power management or buffer
    overflow can cause serial communication to hang.
    [SUNLU_AMS_Heater_AutoVent.ino]
2026-02-13 Add Windows serial monitor application with auto-detect and color-coding
    New Files:
    - serial_monitor.py: Python/tkinter GUI serial monitor
    - requirements.txt: Python dependencies (pyserial)
    - SERIAL_MONITOR_README.md: Complete user documentation
    - build_windows_exe.bat: One-click .exe builder for Windows
    Features:
    - Auto-detect Arduino/SAMD21 boards by VID/PID
    - Auto-reconnect on USB disconnect (2s retry)
    - Color-coded output parsing:
    * Green: Opening vent, heater on
    * Blue: Closing vent, heater off
    * Yellow: Debug messages, warnings
    * Red: Errors
    * Cyan: Calibration messages
    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
    [serial_monitor.py]
2026-02-13 Reorganize serial monitor into SerialMonitor folder and add command input
    Folder Structure:
    - Created SerialMonitor/ folder for better organization
    - Moved all serial monitor files into dedicated folder
    - Renamed SERIAL_MONITOR_README.md to README.md
    New Features - Command Input:
    - Added Quick Command buttons:
    * Learn Mode (L) - Start learning mode without button press!
    * Open Vent (O) - Manually open vent
    * Close Vent (C) - Manually close vent
    * Recalibrate (R) - Recalibrate servo
    * Standby (S) - Toggle standby mode
    * Feedback (F) - Read servo position
    - Added manual input field:
    * Type any command and press Enter
    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
2026-02-13 Add troubleshooting tools for 'No module named serial' error
    - install_dependencies.bat: Robust installer that tries multiple methods
    - test_imports.py: Diagnostic script to check all dependencies
    - install_dependencies.bat tries 3 different pip installation methods
    - test_imports.py shows Python version, paths, and missing modules
    - Clear error messages and fix instructions
    - Works with multiple Python installations
    Updated README:
    - Added comprehensive "No module named serial" troubleshooting section
    - 6 different methods to fix the issue
    - Step-by-step instructions for each method
    - Covers multiple Python installations, Administrator mode, etc.
    Usage:
    1. Run: insta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
    [test_imports.py]
2026-02-13 Add 'N' (Next) serial command to advance learning mode phases remotely
    Arduino Firmware Changes:
    - Added 'N' or 'n' serial command to advance learning mode
    - Simulates button press without physical access
    - Shows helpful messages if not in learning mode
    - Updated serial command help text
    Serial Monitor Changes:
    - Added "Next Phase" button to quick commands
    - Placed right after "Learn Mode" for logical flow
    - Button sends 'N' command to Arduino
    Documentation:
    - Complete step-by-step remote learning workflow
    - 8-step process with visual feedback descriptions
    - Benefits: no physical access needed, remote setup
    - Examples using 'N' command
    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
2026-02-13 Fix 'N' command not working during learning mode
    Critical bug fix: Serial command processing was happening AFTER the
    learning mode early return, so commands were never checked when in
    learning mode.
    Moved serial command processing (lines 1246-1327) to BEFORE learning
    mode processing so 'N' command can advance learning phases remotely.
    [SUNLU_AMS_Heater_AutoVent.ino]
2026-02-13 Add UF2 firmware files for both hardware versions
    - v1.uf2: Servo open at 10°, closed at 170°
    - v2.uf2: Servo open at 0°, closed at 180° (default)
    Both files are 115KB and ready for SAMD21 installation.
    Users can drag-and-drop to board in bootloader mode.
    Updated .gitignore to allow UF2 files in repository.
2026-02-13 Add firmware version display at startup
    - Added FIRMWARE_VERSION "2.0.0" (semantic versioning)
    - Display firmware version, build date/time at startup
    - Display hardware version in startup banner
    - Version 2.0.0 marks stable release with:
    - Dual board support (SAMD21/RP2040)
    - Remote learning mode via serial commands
    - Windows serial monitor application
    Startup banner now shows:
    - Firmware Version: 2.0.0
    - Build Date: [compile date/time]
    - Hardware Version: 1 or 2
    - Board type (SAMD21 or RP2040)
2026-02-13 Throttle debug output to once every 5 seconds
    Reduced serial output frequency to prevent flooding the console:
    - Added g_lastDebugOutputMs timer variable
    - Debug output (Irms, voltage, fan/heater status) now displays
    every 5 seconds instead of every 100ms loop iteration
    - Important status messages (vent open/close, learning mode, etc.)
    still display immediately when they occur
    This makes the serial monitor much more readable while still
    providing regular status updates.
    [SUNLU_AMS_Heater_AutoVent.ino]
2026-04-03 Add detailed Arduino IDE setup instructions for SAMD21 and RP2040
2026-04-03 Rebuild UF2 firmware for both SAMD21 and RP2040
    Add pre-built UF2 files for all board/design combinations:
    - RP2040 v1, RP2040 v2, SAMD21 v1, SAMD21 v2
    Renamed files to clearly indicate board type.
2026-04-25 Fix Heat OFF threshold so heater-off-fan-on transition is detected
    The learned Heat OFF threshold was placed between baseline and fan-only
    current, which sits below the steady fan-only current. When the heater
    turned off but the fan kept running, Irms stayed above the threshold
    and g_heaterOn never cleared until the fan also stopped. Recompute Heat
    OFF as 25% of the way from fan-only up to heater current — well above
    fan-only and below Heat ON, giving a proper hysteresis band.
    [SUNLU_AMS_Heater_AutoVent.ino]
2026-09-08 Add ACS758 connectivity self-test at boot
    Verifies the current sensor is actually wired to ADS1115 A0 before any
    reading is trusted, using three checks that need no load current:
    1. DC bias - an idle bidirectional ACS758 parks at Vcc/2 (~2.5V). The
    dryer is an AC load, so its current averages to zero and
    cannot shift the DC mean; a mean far from Vq is therefore
    a wiring fault, not a measurement.
    2. Mux drag - reads A0 immediately after charging the ADS1115 sampling
    cap on A1 to spot a high-impedance (disconnected) pin.
    3. Noise - pk-pk spread over the sample window.
    Verdicts are worst-fault-wins and advisory only: a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
    [SUNLU_AMS_Heater_AutoVent.ino]
2026-09-08 Add .gitattributes and normalize line endings to LF
    SUNLU_AMS_Heater_AutoVent.ino was stored CRLF while every other tracked
    text file was already LF. Any tool that rewrote the sketch with LF
    produced a ~3400-line phantom diff that buried the real change.
    Pin the policy in .gitattributes and renormalize the one offending file.
    The sketch portion of this commit is EOL-only: empty under
    `git diff --ignore-cr-at-eol`.
    The tracked .uf2 firmware images are marked binary explicitly so EOL
    translation can never corrupt them.
    LF verified to build clean on both targets (RP2040 78,964 B /
    SAMD21 60,380 B).
2026-09-14 Rebuild RP2040 UF2 firmware from current source
    The previous RP2040 builds (2026-04-03) predated the Heat OFF threshold fix
    and the ACS758 connectivity self-test. Rebuilt v1 (HARDWARE_VERSION 1) and v2
    (HARDWARE_VERSION 2) with arduino-cli, rp2040:rp2040 5.5.0,
    FQBN rp2040:rp2040:seeed_xiao_rp2040. SAMD21 UF2s not rebuilt.
    Claude-Session: https://claude.ai/code/session_014E6TduM4dEYsG7uwK1iiZg
2026-10-26 Add servo travel-limit setup (auto-find and jog) so the servo never stalls at the stops
    Calibration used to drive the servo to 0 and 180 degrees, past the vent's
    hard stops, and every open/close did the same. The servo travel limits are
    now set once and saved in flash, and all moves stay between them.
    - A: auto-find. Measures the feedback slope over free travel (70-100 deg),
    creeps 2 deg at a time toward each end until the shaft falls 5 deg behind
    the command, and backs off 12.7% of the measured travel from each stop.
    - J: jog mode. Step 1 or 5 deg, mark CLOSED (C) and OPEN (O), save (W),
    cancel (Q), delete saved limits (D). Starts at 90 deg mid-travel and warns
    when the feedback st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
2026-10-26 Remove unused calibrateServo()
    Nothing called it, and it was the last code path that swept the servo to
    the full 0/180 range. Source only; UF2s not rebuilt (no behavior change).
2026-10-26 Update docs for servo setup: LED patterns, first-boot timing, tech spec
    - LED tables: double blink now means the servo is not set up; fast flash
    also covers servo setup (README, user guide, tech spec).
    - First startup notes that finding the stops adds roughly 20-30 seconds.
    - Short-press recalibration now describes moving between the saved limits.
    - Tech spec: servo range note, new A/J/? and setup-mode commands, servo
    limits storage, rewritten calibration section (auto-find algorithm), and
    the setup-failure error case.
2026-11-01 Add photo build guide and fix vent timing and sensor docs
    Add BUILD_GUIDE.md, a step-by-step assembly and installation guide
    illustrated with 27 photos taken from the AutoVent 2.0 build video.
    Parts follow the 3dcreator.shop BOM, with corrections for the latest
    PCB (straight ACS758 headers, Dupont button/LED headers), the ACS758
    pin mapping, and barrel-jack or USB-C power options. Link it from
    the README.
    Fix the vent timing in README and USER_GUIDE to match the firmware:
    only the heater opens the vent, the 3-minute delay applies while the
    fan runs after the heater stops, and the vent closes immediately when
    the dryer is fully off. Replace clip-on current sensor troubleshooting
    with checks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
2026-11-01 Add PCB connection map and AC wiring diagrams to build guide
    Add two SVG diagrams drawn from the Rev 2.0 PCB layout: a connection
    map showing every connector's pins (button, LED, ADS1115, servo, 5V
    input, capacitor, and the ACS758 module to J4 with pin 3 unused), and
    an AC wiring diagram showing one conductor routed through IP-/IP+.
    Remove the instruction to connect a ground conductor (the C7/C8 cord is
    two-conductor), and give the 5V terminal polarity by silkscreen pin
    instead of camera angle.
2026-11-01 Build guide: servo header is a straight 4-pin on the latest PCB
2026-11-01 Build guide: ADS1115 mounts flat against the latest PCB
2026-11-01 Build guide: add Jog Mode steps for setting servo limits by hand
2026-11-01 Build guide: specify micro 9g servo size and BOM part
2026-11-01 Build guide: screws come in the kit; add power cable grommet step
2026-11-01 README: list the illuminated pushbutton and current power options
2026-11-01 Build guide: drop notes saying the shop BOM is out of date
